kritikagithubtripathi/SOHO_Gigabit_Network_Switch/IMG/WhatsApp Image 2024-12-17 at 20.58.13_35f5fbce.jpg

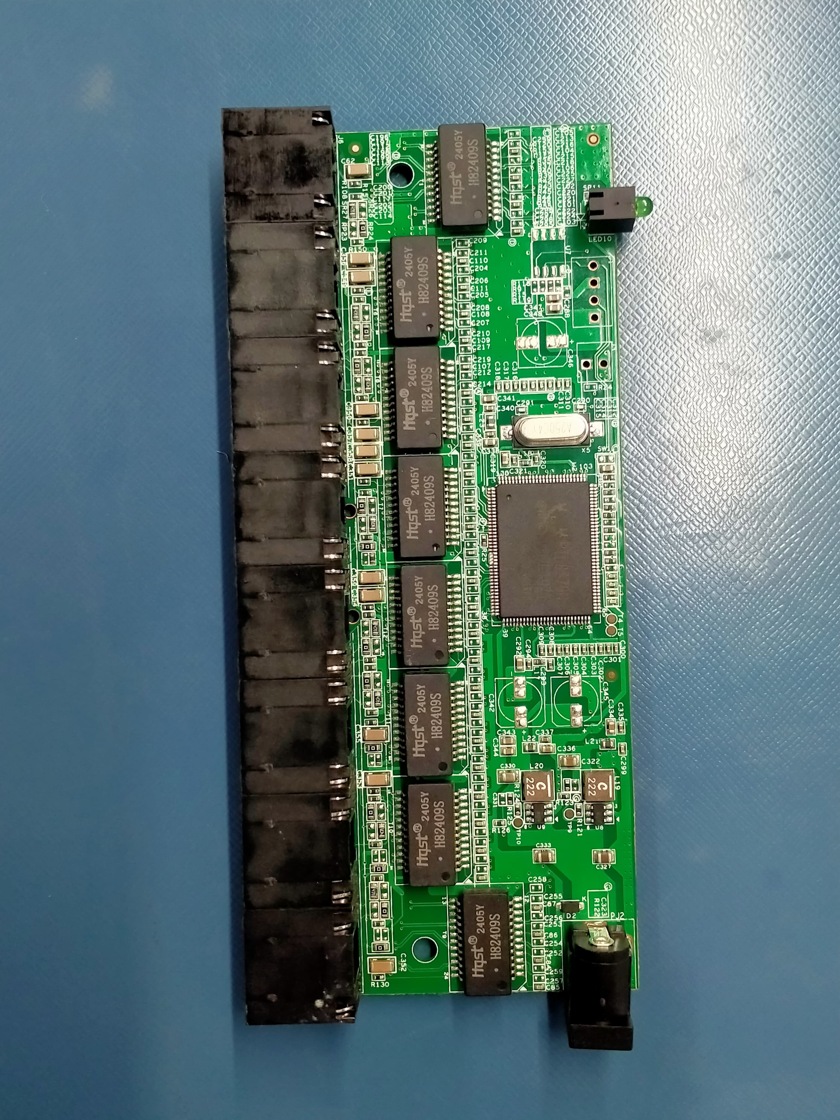
IMG/WhatsApp Image 2024-12-17 at 20.58.13_35f5fbce.jpg
