kritikagithubtripathi/SOHO_Gigabit_Network_Switch/IMG/WhatsApp Image 2024-12-17 at 20.58.07_0a7a4c7c.jpg

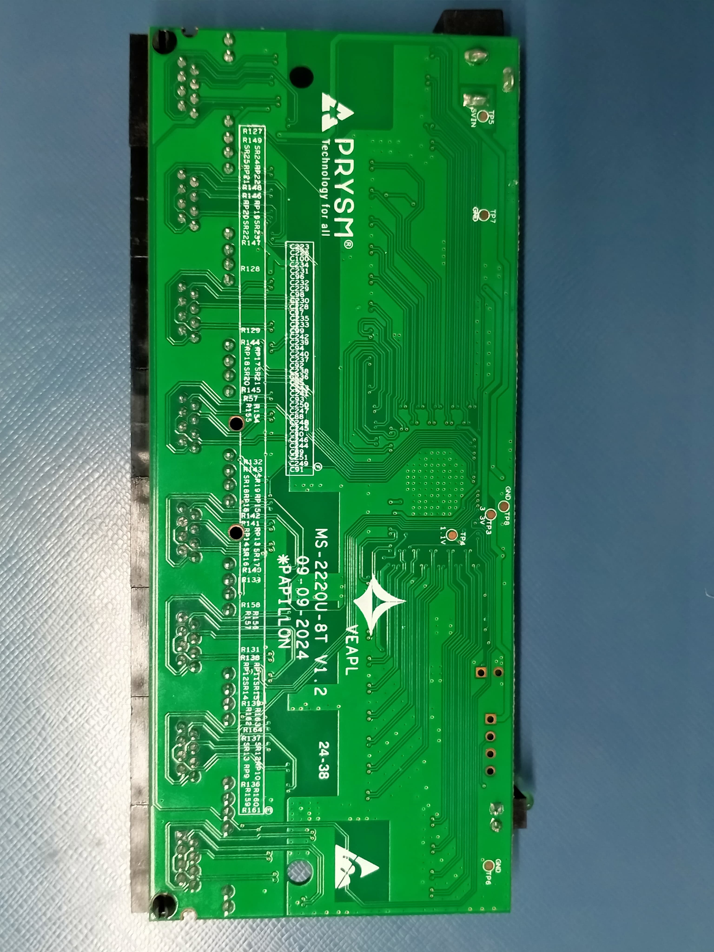
IMG/WhatsApp Image 2024-12-17 at 20.58.07_0a7a4c7c.jpg
