kritikagithubtripathi/SOHO_Gigabit_Network_Switch/IMG/WhatsApp Image 2024-12-17 at 20.58.14_88e8f59b.jpg

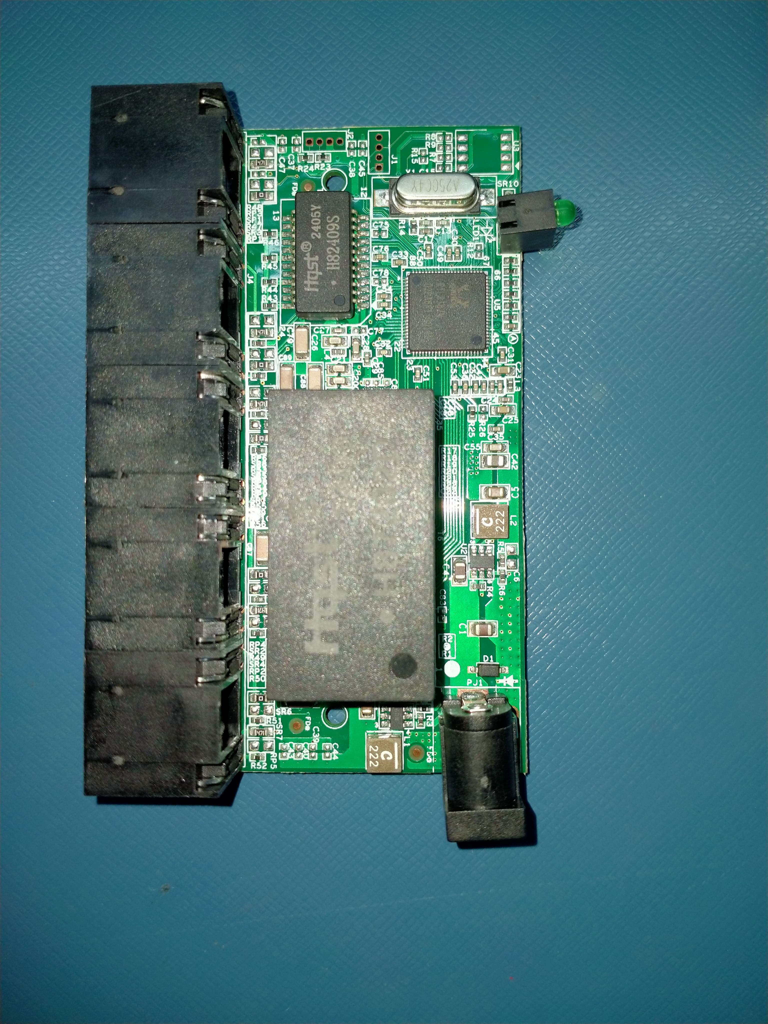
IMG/WhatsApp Image 2024-12-17 at 20.58.14_88e8f59b.jpg
