kritikagithubtripathi/SOHO_Gigabit_Network_Switch/Bill_of_Material(BOM)/Kyi - Leo MS -2210U-5T BOM.xlsx

Sheet: Revision History
 | Product Assembly BOM |  | QF / EG / 01 |  | Rev No. 3
 |  |  | Issue 02
Product Name : | Kyi-Leo - MS-2210U-5T
Product Code: | VEPL-MS-2210U-5T
Revision history:
Release Date | Rev No. | Change Description | Prepared By | Checked By | Remarks
12.04.2019 | 1 | Initial Release | Zaid | Nishath
24.08.2024 | 2 | 1.Power Circuit has been Changed - U1, U2 2.DNI List Update - U3, U4, C15, C16, R9, R13, R16 | Kritika | Zaid |  | 2
27.08.2024 | 3 | 3. Changed VEPL PN from VEPL418391215 to VEPL41839121 due to digit missmatch 4.Changed VEPL PN from VEPL218372007 to VEPL21837200 due to digit missmatch 5.Changed VEPL PN from VEPL318448360 to VEPL31844836 due to digit missmatch 6.Changed VEPL PN from VEPL418421001 to VEPL41842100 due to digit missmatch 7.Changed VEPL PN from VEPL418411000 to VEPL41841100 due to digit missmatch | Anitha | Ranjitha
2024-09-09 | 4 | 1.Added mechanical parts 2.Changed VEPL PN from VEPL118612010 to VEPL11861201 due to digit missmatch 3.Changed VEPL PN from VEPL118622002 to VEPL11862200 due to digit missmatch 4.Changed VEPL PN from VEPL118632210 to VEPL11863221 due to digit missmatch 5.Changed VEPL PN from VEPL118642215 to VEPL11864221 due to digit missmatch 6.Changed VEPL PN from VEPL718381545 to VEPL71838154 due to digit missmatch | Anitha | Ranjitha
09.10.2024 | 5 | Change RTL8367N-VB to RTL8367N-VB-CG | Kritika | Mayank

Sheet: BOM
 |  |  | Product Assembly BOM |  |  |  |  |  |  | QF / EG / 01 |  |  | Rev No. 3
 |  |  |  |  |  |  |  |  |  | Issue 02
Product Name : |  |  | Kyi-Leo - MS-2210U-5T |  |  |  |  |  | BOM Rev No: | 4 | Product Rev No: |  |  | 1.1
Product Code: |  |  | VEPL-MS-2210U-5T |  |  |  | BOM Type : |  | Issue Date: | 2024-09-09
Total No. of Line Items: |  |  | 28 |  |  |  | Total SMT locations: | 91 | Total PTH locations: | 4
Sl no. | Level | VEPL Part No | Prioprity Level | Value | PCB Footprint | Type | Description | Mfr | Mfr. Part No | Customer Part No | Qty/ Product | UOM | Reference | Assy Stage | MSL | ECN | Select BOM Type | MSL | Assy Stage
1 | 4 | VEPL25430407 | 1 | 4.7uF | C0805 | CAP | 4.7 uF, Ceramic Capacitor, 10V, X7R, size 0805 | Murata Samsung Electro-Mechanics TDK Corporation KEMET YAGEO | GRM21BR71A475KA73L CL21B475KPFNNNE C2012X7R1A475K125AC C0805C475K8RAC7800 CC0805KKX7R6BB475 |  | 2 | EA | C1,C4 | SMD |  |  | Design Validation | L1 | SMT
2 | 4 | VEPL24251000 | 1 | 10uF | C0805 | CAP | 10 uF, Ceramic Capacitor, 10V, X7R, size 0805 | Murata Samsung Electro-Mechanics YAGEO TDK Corporation KEMET | GRM21BR71A106KE51L CL21B106KPQNFNE CC0805KKX7R6BB106 C2012X7R1A106K125AC C0805C106K8RAC7800 |  | 2 | EA | C2,C5 | SMD |  |  | Engineering Validation | L2 | PTH
3 | 4 | VEPL21239030 | 1 | 30pF | C0402 | CAP | CAP CER 30PF 25V C0G/NP0 0402 | Murata Johanson Technology Inc. KEMET Venkel Vishay Vitramon | GRM1555C1E300JA01D QSCF250Q300J1GV001T C0402C300J3GAC7867 C0402C0G250-300JNE VJ0402D300JXXAC |  | 2 | EA | C13,C14 | SMD |  |  | Mfg Pilot | L3 | FA/BB
4 | 4 | VEPL21834160 | 1 | 0.1uF | C0402 | CAP | CAP CER 0.1UF 16V X5R 0402 | Murata KYOCERA AVX KEMET YAGEO Walsin Technology Corporation | GRM155R61C104KA88D KGM05AR51C104KH C0402C104K4PAC7867 CC0402KRX5R7BB104 0402X104K160CT |  | 6 | EA | C17,C18,C22,C24,C27,C29 | SMD |  |  | Mass Production |  | Consumables
5 | 4 | VEPL23640160 | 1 | 1UF/16V | C0603 | CAP | CAP CER 1UF 16V X5R 0603 | KEMET KYOCERA AVX Murata Electronics TDK TAIYO YUDEN | C0603C105K4PACTU KGM15BR51C105KT GRM185R61C105KE44J CGA3E1X5R1C105K080AC EMK107BJ105KAHT |  | 8 | EA | C19,C20,C21,C23,C25,C26,C28,C55 | SMD |  |  |  |  | Mechanical
6 | 4 | VEPL21836161 | 1 | 0.01uF | C0402 | CAP | CAP CER 0.01UF 16V X7R 0402 | Walsin Technology Murata Electronics YAGEO KEMET Samsung Electro-Mechanics | 0402B103K160CT GRM155R71C103KA01D CC0402KRX7R7BB103 C0402C103K4RAC7867 CL05B103KO5NNNC |  | 16 | EA | C30,C31,C32,C33,C34,C35,C36,C41, C48,C49,C50,C51,C52,C53,C54,C76 | SMD |  |  |  |  | Label
7 | 4 | VEPL21833161 | 1 | 10UF/16V | C0805 | CAP | CAP CER 10UF 16V X5R 0805 | Samsung Murata Electronics KEMET TDK Corporation YAGEO | CL21A106KOCLRNC GRM21BR61C106KE15K C0805C106K4PAC7800 C2012X5R1C106K085AC CC0805KKX5R7BB106 |  | 1 | EA | C42 | SMD
8 | 4 | VEPL21837200 | 1 | 1nF/2kv | C1206 | CAP | CAP CER 1000PF 2KV X7R 1206 | KEMET Vishay / Vitramon KYOCERA AVX YAGEO | C1206C102KGRACTU VJ1206Y102KXFAT4X 1206GC102KAZ1A CC1206KKX7RDBB102 |  | 5 | EA | C79,C82,C87,C88,C89 | SMD
9 | 4 | VEPL36063005 | 1 | AZ3005-01G | SOD123 | Diode | TVS SURGE PROTECTOR 1-CH 5V | AMAZING | AZ3005-01G |  | 1 | EA | D1 | SMD
10 | 4 | VEPL71838154 | 1 | rj451x5 | rj45_5port | CONN | CONN 1X5 With Two LED - RJ45, Plastic | UTE | 31124.50101.011300 |  | 1 | EA | J4 | PTH
11 | 4 | VEPL41240364 | 1 | LED(RED) | LED | LED | Right angle Green LED TH | Kohon Opto Electronics | KHL3642GD43-DZ |  | 1 | EA | LED1 | PTH
12 | 4 | VEPL35431202 | 1 | 2.2uH | XAL4020-222ME | IND | FIXED IND 2.2UH 5.5A 38.7MOHM SM | Colicraft | XAL4020-222MEC |  | 2 | EA | L1,L2 | SMD
13 | 4 | VEPL41839121 | 1 | SBY100505T-121Y-(500mA) | L0402 | BEAD | Ferrite Bead 120Ohm @100Mhz 500mA | CHILISIN ELECTRONICS CORP | SBY100505T-121Y |  | 2 | EA | L3,L4 | SMD
14 | 4 | VEPL71309039 | 1 | DC JACK | DC_JB11_03 | CONN | CONN PWR JACK 2 X 5.5 MM | JCTC | JAB11-03BH911XAL-X 2.0mm |  | 1 | EA | PJ1 | PTH
15 | 4 | VEPL11490000 | 1 | 0R | R0603 | RES | RES SMD 0 OHM JUMPER 1/10W 0603 | Panasonic YAGEO Stackpole Electronics Vishay Dale | ERJ-3GEY0R00V AF0603FR-070RL RMCF0603ZT0R00 CRCW06030000Z0EA |  | 5 | EA | RP1,RP4,RP7,RP8,RP10 | SMD
16 | 4 | VEPL11100453 | 1 | 453K | R0402 | RES | RES 453K OHM 1% 1/16W 0402 | YAGEO Bourns Inc. Vishay Dale Stackpole Electronics Inc | RC0402FR-07453KL CR0402-FX-4533GLF CRCW0402453KFKED RMCF0402FT453K |  | 1 | EA | R1 | SMD
17 | 4 | VEPL12900100 | 1 | 100K | R0402 | RES | RES 100K OHM 1% 1/10W 0402 | Panasonic KOA Speer Electronics, Inc. Würth Elektronik Kamaya | ERJ-2RKF1003X RK73H1ETTP1003F 560112110019 RMC1/16SK1003FTH |  | 2 | EA | R2,R6 | SMD
18 | 4 | VEPL11290499 | 1 | 499K | R0402 | RES | RES 499K OHM 1% 1/10W 0402 | Panasonic KOA Speer Electronics, Inc. Kamaya | ERJ-2RKF4993X RK73H1ETTP4993F RMC1/16SK4993FTH |  | 2 | EA | R3,R4 | SMD
19 | 4 | VEPL14523825 | 1 | 82.5K | R0402 | RES | RES 82.5K OHM 1% 1/16W 0402 | YAGEO Bourns Inc. Stackpole Electronics Inc Vishay Dale KOA Speer Electronics, Inc | RT0402FRE0782K5L CR0402-FX-8252GLF RMCF0402FT82K5 CRCW040282K5FKED RN73H1ETTP8252F25 |  | 1 | EA | R5 | SMD
20 | 4 | VEPL11126407 | 1 | 4.7K | R0402 | RES | RES SMD 4.7K OHM 5% 1/10W 0402 | Panasonic KOA Speer Electronics, Inc. Kamaya Inc. Walsin Technology Corporation | ERJ-2GEJ472X RK73B1ETTP472J RMC1/16S-472JTH MR04X472 JTL |  | 17 | EA | R14,R17,R18,R19,R20,R21,R22,R23,R24,R49,R50,R51,R52,R53,R54,R55,R56 | SMD
21 | 4 | VEPL11840249 | 1 | 2.49K | R0402 | RES | RES SMD 2.49K OHM 1% 1/10W 0402 | Panasonic KOA Speer Electronics, Inc. Würth Elektronik Kamaya Inc. | ERJ-2RKF2491X RK73H1ETTP2491F 560112110224 RMC1/16SK2491FTH |  | 1 | EA | R25 | SMD
22 | 4 | VEPL11243075 | 1 | 75R | R0402 | RES | RES SMD 75 OHM 5% 1/10W 0402 | Panasonic KOA Speer Electronics, Inc. Kamaya Inc. Würth Elektronik | ERJ-2GEJ750X RK73B1ETTP750J RMC1/16S-750JTH 560112110028 |  | 4 | EA | R43,R44,R45,R46 | SMD
23 | 4 | VEPL11330470 | 1 | 470R | R0603 | RES | RES SMD 470 OHM 5% 1/10W 0603 | Yageo Vishay Dale Panasonic TE Connectivity Stackpole Electronics Inc | RC0603JR-07470RL CRCW0603470RJNEBC ERJ-3GEYJ471V CRGCQ0603J470R RMCF0603JT470R |  | 6 | EA | SR1,SR4,SR7,SR8,SR10,SR11 | SMD
24 | 4 | VEPL41841100 | 1 | HS2401S | sop24 | Module | 10/100/1000 BASE-T Single PORT SMD MODULE | HQST | HS2401S H82409S |  | 1 | EA | T5 | SMD
25 | 4 | VEPL41842100 | 1 | LP5027NL | DIP72 | Module | 10/100/1000 BASE-T QUAD PORT TH MODULE | LINK PP | LP5027NL |  | 1 | EA | T6 | PTH
26 | 4 | VEPL35432236 | 1 | TLV62569PDDC | SOT23-6 | Converter | IC REG BUCK ADJ 2A SOT23-6 | TI | TLV62569PDDC |  | 2 | EA | U1,U2 | SMD
27 | 4 | VEPL31844836 | 1 | RTL8367N-VB-CG | QFN88 | IC | 5 Port 10/100/1000M IC_ | Realtek | RTL8367N-VB-CG |  | 1 | EA | U5 | SMD
28 | 4 | VEPL94510252 | 1 | 25MHZ | CRY_2P_HC_49SMD | Crsytal | CRYSTAL 25.0000MHZ 18PF SMD | Abracon LLC | ABLS-25.000MHZ-B2F-T |  | 1 | EA | X1 | SMD
29 | 4 | VEPL918458012 |  | NA |  | PCB | Bare PCB - MS-2210U - PCB Dimension : 80.5 (L) * 46.8 (W) * 1.2 (T) ,FR4 Material , 2 Layer ,OSP Finish ,1oz Copper thickness . | i)Epitome Components Ltd ii) Guangdong Champion Asia Electronics Co Ltd. iii) Ascent Circuits Pvt Ltd iv) Shenzhen Posin Circuit Technology Co Ltd v) Ucreate PCB Co Ltd vi) Global Success Circuits Co LTD vii) Shye Feng Enterprise (Thailand) co LTD Viii) Gerg Electronics (INDIA Circuit ) iX) HECPCB TECHNOLOGY CO., LTD | NA |  | NA | NA | NA | NA
30 | 1 | VEPL91459020 |  |  |  |  | Power Adapter - 5V , 1Amp - DC PIN - 5.5 x 2.1mm | Velankani Electronics PvT LTD Velankani Electronics PvT LTD | PA011205020 PRYSM5V1P2A |  | 1 | EU
31 | 2 | VEPL11861201 |  |  |  |  | SoHo TOP Cover - Plastic | Velankani Electronics PvT LTD - Unit-II | NW-2001-P-0001 |  | 1 | EU
32 | 2 | VEPL11862200 |  |  |  |  | SoHo Bottom Cover - Plastic | Velankani Electronics PvT LTD - Unit-II | NW-2001-P-0002 |  | 1 | EU
33 | 2 | VEPL11863221 |  |  |  |  | Gift BOX - 170 x 110 x 54mm | Velankani Electronics PvT LTD - Unit-II | PKG- MS-2210U-5T |  | 1 | EU
34 | 2 | VEPL11864221 |  |  |  |  | MS-2210U-5T - UNIT Lable | Velankani Electronics PvT LTD - Unit-II | LABLE- MS-2210U-5T |  | 2 | EU
Approved By: |  |  |  |  |  |  |  | Note :
Name: |  | Ranjitha |  |  |  |  |  | EA ------> Each Assembly ; EU ------> Each Unit ; SMT -----> Surface Mount Device Assy ; T.H ------> Through Hole Assy
Date: |  | 2024-09-09

Sheet: DNP
 | Product Assembly BOM |  |  | QF / EG / 01 |  | Rev No. 3
 |  |  |  | Issue 02
Product Name : | Kyi-Leo - MS-2210U-5T |  |  | BOM Rev No: | 4 | Product Rev No: | 1.1
Product Code: | VEPL-MS-2210U-5T |  |  | Issue Date: | 2024-09-09
DONOT POPULATE LIST
Sl No. | Qty / Product | Reference | PCB Footprint | Remarks
1 | 2 | C3,C6 | C0603 | 6.8pF/NC
1 | 2 | C15,C16 | C0402 | 0.1uF/NC
2 | 15 | C37,C38,C39,C40,C43,C44,C45,C47,C75,C77,C78,C83,C84,C85,C86 | C0402 | 0.01uF/NC
3 | 1 | C46 | C0805 | 10UF/16V/NC
4 | 1 | C56 | C0603 | 1UF/16V/NC
5 | 2 | J1,J2 | sip_4p_1-27p | NC-1X4PIN
6 | 1 | RA1 | 8P4r22 | NC-33/5%
7 | 5 | RP2,RP3,RP5,RP6,RP9 | R0603 | 0R/NC
8 | 12 | R7,R8,R9,R10,R11,R12,R13,R15,R16,R26,R47,R48 | R0402 | NC/4.7K
9 | 5 | SR2,SR3,SR5,SR6,SR9 | R0603 | 470R/NC
10 | 1 | SW1 | R0603 | NC
11 | 1 | U3 | SO8 | AT24C01D-SSHM-B / NC
12 | 8 | TP1,TP2,TP3,TP4,TP5,TP6,TP7,TP8 | T POINT A
13 | 1 | U4 | sop8_300 | W25Q80_0
Approved By:
Name: | Ranjitha
Date: | 2024-09-09
