kritikagithubtripathi/SOHO_Gigabit_Network_Switch/Bill_of_Material(BOM)/PAPILLION MS-2220U-8T BOM.xlsx

Sheet: Revision History
 | Product Assembly BOM |  | QF / EG / 01 |  | Rev No. 3
 |  |  | Issue 02
Product Name : | Papillon - MS-2220U-8T
Product Code: | VEPL-MS-222U-8T
Revision history:
Release Date | Rev No. | Change Description | Prepared By | Checked By | Remarks
12.04.2019 | 1 | Initial Draft | Zaid | Nishath
09.07.2019 | 2 | Initial Release | Zaid | Jayanth
28.08.2024 | 3 | 1.Power Circuit has been Changed - U8, U9 2.DNI List Update -C288, R9 | Kritika | Zaid
2024-08-29 | 4 | Changed VEPL718482845 to VEPL71848284 due to digit miss match Changed VEPL318518370 to VEPL31851837 due to digit miss match | Manjunath | Ranjitha
2024-09-10 | 5 | 1.Changed VEPL118652003 to VEPL11865200 due to digit missmatch 2.Changed VEPL118662004 to VEPL11866200 due to digit missmatch 3.Changed VEPL118672208 to VEPL11867220 due to digit missmatch 4.Changed VEPL118682228 to VEPL11868222 due to digit missmatch | Anitha | Ranjitha
09.10.2024 | 6 | Change RTL8370N-VB to RTL8370N-VB-CG | Kritika | Mayank

Sheet: BOM
 |  |  | Product Assembly BOM |  |  |  |  |  |  | QF / EG / 01 |  |  | Rev No. 3
 |  |  |  |  |  |  |  |  |  | Issue 02
Product Name : |  |  | Papillon - MS-2220U-8T |  |  |  |  |  | BOM Rev No: | 5.0 | Product Rev No: |  |  | 1.2
Product Code: |  |  | VEPL-MS-222U-8T |  |  |  | BOM Type : | Design Validation | Issue Date: | 2024-09-10
Total No. of Line Items: |  |  | 27 |  |  |  | Total SMT locations: | 175 | Total PTH locations: | 3
Sl no. | Level | VEPL Part No | Prioprity Level | Value | PCB Footprint | Type | Description | Mfr | Mfr. Part No | Customer Part No | Qty/ Product | UOM | Reference | Assy Stage | MSL | ECN | Select BOM Type | MSL | Assy Stage
1 | 4 | VEPL21837200 | 1 | 1nF/2kv | C1206 | CAP | CAP CER 1000PF 2KV X7R 1206 | KEMET YAGEO Johanson Dielectrics Inc. Vishay/Vitramon | C1206C102KGRACTU CC1206KKX7RDBB102 VPDD202W102K1GV001E 77-VJ1206Y102KXFAT4X |  | 12 | EA | C62,C349,C350,C351,C352,C353,C354,C355,C356,C357,C358,C359 | SMT |  |  | Design Validation | L1 | SMT
2 | 4 | VEPL21836161 | 1 | 0.01uF / 16V | C0402 | CAP | CAP CER 0.01UF 16V X7R 0402 | Walsin Technology Murata Electronics KEMET YAGEO Samsung Electro-Mechanics | 0402B103K160CT GRM155R71C103KA01J C0402T103K4RACTU CC0402KRX7R7BB103 CL05B103KO5NNNC |  | 56 | EA | C84,C85,C86,C87,C88,C89,C90,C91,C92,C93,C94,C95,C96,C97,C98,C99, C100,C101,C102,C103,C104,C105,C106,C107,C108,C109,C110,C111,C112,C113,C114,C117 C295,C296,C297,C298,C299,C300,C301,C302,C303,C304,C305, C306,C307,C308,C309,C310,C311,C312,C313,C314,C315,C316,C317,C318 | SMT |  |  | Engineering Validation | L2 | PTH
3 | 4 | VEPL23640160 | 1 | 1uF/16V | C0603 | CAP | CAP CER 1UF 16V X5R 0402 | KEMET Murata Electronics KYOCERA AVX TDK TAIYO YUDEN | C0603C105K4PACTU GRT188R61C105KE13D 0603YD105KAT2A C1608X5R1C105K080AA EMK107BJ105KK-T |  | 11 | EA | C289,C292,C319,C334,C336,C338,C341,C343,C344,C347,C348 | SMT |  |  | Mfg Pilot | L3 | FA/BB
4 | 4 | VEPL21239030 | 1 | 30pF | C0402 | CAP | CAP CER 30PF 25V C0G/NP0 0402 | Murata KEMET Venkel Johanson Technology Inc. Vishay Vitramon | GRM1555C1E300JA01D C0402C300J3GAC7867 C0402C0G250-300JNE QSCF250Q300J1GV001T VJ0402D300JXXAC |  | 2 | EA | C290,C291 | SMT |  |  | Mass Production |  | Consumables
5 | 4 | VEPL21834160 | 1 | 0.1uF | C0402 | CAP | CAP CER 0.1UF 16V X5R 0402 | Murata KYOCERA AVX KEMET Samsung Electro-Mechanics TDK Corporation | GRM155R61C104KA88D KGM05AR51C104KH C0402C104K4PAC7867 CL05A104KO5NNNC C1005X5R1C104K050BA |  | 8 | EA | C293,C294,C320,C321,C335,C337,C339,C340 | SMT |  |  |  |  | Mechanical
7 | 4 | VEPL24251000 | 1 | 10uF | C0805 | CAP | 10 uF, Ceramic Capacitor, 10V, X7R, size 0805 | Murata Samsung Electro-Mechanics YAGEO TDK Corporation KEMET | GRM21BR71A106KE51L CL21B106KPQNFNE CC0805KKX7R6BB106 C2012X7R1A106K125AC C0805C106K8RAC7800 |  | 2 | EA | C322,C330 | SMT |  |  |  |  | Label
8 | 4 | VEPL25430407 | 1 | 4.7uF | C0805 | CAP | 4.7 uF, Ceramic Capacitor, 10V, X7R, size 0805 | Murata Samsung Electro-Mechanics TDK Corporation KEMET YAGEO | GRM21BR71A475KA73L CL21B475KPFNNNE C2012X7R1A475K125AC C0805C475K8RAC7800 CC0805KKX7R6BB475 |  | 2 | EA | C327,C333 | SMT
9 | 4 | VEPL36063005 | 1 | AZ3005-01G | SOD123 | Diode | TVS SURGE PROTECTOR 1-CH 5V | AMAZING | AZ3005-01G |  | 1 | EA | D2 | SMT
10 | 4 | VEPL71848284 | 1 | 1X8_2LED | 1X8_2LED | Conn | 1X8 Plastic With 2LED RJ45 Connector | UTE | 31124.80101.011300 |  | 1 | EA | J6 | PTH
11 | 4 | VEPL41240364 | 1 | LED(RED) | LED-1PORT-2p54MM | LED | Right angle Green LED TH | Kohon Opto Electronics | KHL3642GD43-DZ |  | 1 | EA | LED10 | PTH
12 | 4 | VEPL41839121 | 1 | SBY100505T-121Y-(500mA) | L0402 | Bead | Ferrite Bead 120Ohm @100Mhz 500mA | CHILISIN ELECTRONICS CORP | SBY100505T-121Y |  | 2 | EA | L17,L18 | SMT
13 | 4 | VEPL35431202 | 1 | 2.2uH | XAL4020-222ME | IND | 2.2uH, Power Inductor | Colicraft | XAL4020-222ME |  | 2 | EA | L19,L20 | SMT
14 | 4 | VEPL41849102 | 1 | 120ohm@100Mhz,2A | L0603 | Bead | Ferrite Bead 120Ohm @100Mhz 2AMax | Vishay Dale | ILHB0603ER121V |  | 3 | EA | L21,L22,L23 | SMT
15 | 4 | VEPL71309039 | 1 | DC JACK | DC_JB11_03 | Conn | CONN PWR JACK 2 X 5.5 MM | JCTC | JAB11-03BH911XAL-X 2.0mm |  | 1 | EA | PJ2 | PTH
16 | 4 | VEPL11490000 | 1 | 0R | R0603 | RES | RES SMD 0 OHM JUMPER 1/10W 0603 | Panasonic Stackpole Electronics YAGEO Vishay Dale | ERJ-3GEY0R00V RMCF0603ZT0R00 RC0603JR-070RL CRCW06030000Z0EA |  | 12 | EA | RP10,RP12,RP14,RP16,RP18,RP20,RP22,RP24,R57,R158,R161,R164 | SMT
17 | 4 | VEPL11126407 | 1 | 4.7K | R0402 | RES | RES SMD 4.7K OHM 5% 1/10W 0402 | Panasonic KOA Speer Electronics, Inc. Kamaya Inc. Walsin Technology Corporation | ERJ-2GEJ472X RK73B1ETTP472J RMC1/16S-472JTH MR04X472 JTL |  | 26 | EA | R9,R120,R136,R137,R138,R139,R140,R141,R142, R143,R144,R145,R146,R147,R148,R149,R150,R151 R37,R40,R42,R44,R46,R152,R154,R156 | SMT
18 | 4 | VEPL11840249 | 1 | 2.49K / 1% | R0402 | RES | RES SMD 2.49K OHM 1% 1/16W 0402 | Walsin Technology Corp. Vishay Dale YAGEO Stackpole Electronics Inc Rohm Semiconductor | WR04X2491FTL CRCW04022K49FKED RC0402FR-072K49L RMEF0402FT2K49 SFR01MZPF2491 |  | 1 | EA | R25 | SMT
21 | 4 | VEPL11243075 | 1 | 75 / 5% | R0402 | RES | RES SMD 75 OHM 5% 1/10W 0402 | Panasonic KOA Speer Electronics, Inc. Kamaya Inc. Würth Elektronik | ERJ-2GEJ750X RK73B1ETTP750J RMC1/16S-750JTH 560112110028 |  | 8 | EA | R108,R127,R128,R129,R130,R131,R132,R133 | SMT
22 | 4 | VEPL11290499 | 1 | 499K | R0402 | RES | RES 499K OHM 1% 1/10W 0402 | Panasonic KOA Speer Electronics, Inc. Kamaya | ERJ-2RKF4993X RK73H1ETTP4993F RMC1/16SK4993FTH |  | 2 | EA | R121,R124 | SMT
23 | 4 | VEPL11100453 | 1 | 453K | R0402 | RES | RES 453K OHM 1% 1/16W 0402 | YAGEO Bourns Inc. Vishay Dale Stackpole Electronics Inc | RC0402FR-07453KL CR0402-FX-4533GLF CRCW0402453KFKED RMCF0402FT453K |  | 1 | EA | R122 | SMT
24 | 4 | VEPL12900100 | 1 | 100K | R0402 | RES | RES 100K OHM 1% 1/10W 0402 | Panasonic KOA Speer Electronics, Inc. Würth Elektronik Kamaya | ERJ-2RKF1003X RK73H1ETTP1003F 560112110019 RMC1/16SK1003FTH |  | 2 | EA | R123,R126 | SMT
25 | 4 | VEPL14523825 | 1 | 82.5K | R0402 | RES | RES 82.5K OHM 1% 1/16W 0402 | YAGEO Bourns Inc. Stackpole Electronics Inc Vishay Dale KOA Speer Electronics, Inc | RT0402FRE0782K5L CR0402-FX-8252GLF RMCF0402FT82K5 CRCW040282K5FKED RN73H1ETTP8252F25 |  | 1 | EA | R125 | SMT
26 | 4 | VEPL11330470 | 1 | 470R | R0603 | RES | RES SMD 470 OHM 5% 1/10W 0603 | Yageo Panasonic Electronic TE Connectivity Passive Product Stackpole Electronics Inc Vishay Dale Bourns Inc. | RC0603JR-07470RL ERJ-3GEYJ471V CRGCQ0603J470R RMCF0603JT470R CRCW0603470RJNEBC CR0603-JW-471ELF |  | 9 | EA | SR11,SR13,SR15,SR17,SR19,SR21,SR23,SR25,SR27 | SMT
27 | 4 | VEPL41841100 | 1 | H82409S | SOP24 | Module | 10/100/1000 BASE-T Single PORT SMD MODULE | HQST HauSheng Semiconductor Tech | H82409S HS2401S |  | 8 | EA | T1,T6,T7,T8,T9,T10,T11,T12 | SMT
28 | 4 | VEPL31851837 | 1 | RTL8370N-VB-CG | LQFP128 | IC | REALTEK, 10/100/1000 8 PORT IC | Realtek Semiconductor Corp. | RTL8370N-VB-CG |  | 1 | EA | U2 | SMT
30 | 4 | VEPL35432236 | 1 | TLV62569PDDC | SOT23-6 | Converter | IC REG BUCK ADJ 2A SOT23-6 | TI | TLV62569PDDC |  | 2 | EA | U8,U9 | SMT
31 | 4 | VEPL94510252 | 1 | 25MHZ | CRY_2P_HC-49SMD | Crystal | CRYSTAL 25.0000MHZ 18PF SMD | Abracon LLC | ABLS-25.000MHZ-B2F-T |  | 1 | EA | X5 | SMT
32 | 4 | VEPL918461275 |  |  |  | PCB | Bare PCB - MS2220U-8T - ,PCB Dimension : 127.8 (L) * 53 (W) * 1.2 (T) ,FR4 Material , 2 Layer ,OSP Finish ,1oz Copper thickness . | i)Epitome Components Ltd ii) Guangdong Champion Asia Electronics Co Ltd. iii) Ascent Circuits Pvt Ltd iv) Shenzhen Posin Circuit Technology Co Ltd v) Ucreate PCB Co Ltd vi) Global Success Circuits Co LTD vii) Shye Feng Enterprise (Thailand) co LTD Viii) Gerg Electronics (INDIA Circuit ) iX) HECPCB TECHNOLOGY CO., LTD
33 |  | VEPL91459020 |  |  |  |  | Power Adapter - 5V , 1Amp - DC PIN - 5.5 x 2.1mm | Velankani Electronics PvT LTD Velankani Electronics PvT LTD | PA011205020 PRYSM5V1P2A
34 |  | VEPL11865200 |  |  |  |  | SoHo TOP Cover - Plastic | Velankani Electronics PvT LTD - Unit-II | NW-2001-P-0003
35 |  | VEPL11866200 |  |  |  |  | SoHo Bottom Cover - Plastic | Velankani Electronics PvT LTD - Unit-II | NW-2001-P-0004
36 |  | VEPL11867220 |  |  |  |  | Gift BOX - 170 x 110 x 54mm | Velankani Electronics PvT LTD - Unit-II | PKG- MS-2220U-8T
37 |  | VEPL11868222 |  |  |  |  | MS-2220U-8T - UNIT Lable | Velankani Electronics PvT LTD - Unit-II | LABLE- MS-2220U-8T
Approved By: |  |  |  |  |  |  |  | Note :
Name: |  | Ranjitha |  |  |  |  |  | EA ------> Each Assembly ; EU ------> Each Unit ; SMT -----> Surface Mount Device Assy ; T.H ------> Through Hole Assy
Date: |  | 2024-09-10

Sheet: DNP
 | Product Assembly BOM |  |  | QF / EG / 01 |  | Rev No. 3
 |  |  |  | Issue 02
Product Name : | Papillon - MS-2220U-8T |  |  | BOM Rev No: | 5 | Product Rev No: | 1.2
Product Code: | VEPL-MS-222U-8T |  |  | Issue Date: | 2024-09-10
DONOT POPULATE LIST
Sl No. | Qty / Product | Reference | PCB Footprint | Remarks
1 | 1 | J1 | SIP_4P_2p54 | CONN HEADER VERT 4POS .100 TIN
2 | 1 | J3 | SIP_2P_2p54 | CONN HEADER VERT 2POS .100 TIN
3 | 8 | RP9,RP11,RP13,RP15,RP17,RP19,RP21,RP23 | R0603 | RES SMD 0 OHM JUMPER 1/10W 0603
4 | 3 | R15,R118,R119 | R0402 | RES SMD 4.7K OHM 5% 1/10W 0402
5 | 1 | R24 | R0402 | NC_33 / 5%
6 | 12 | R35,R39,R43,R45,R55,R153,R155,R157,R159,R160,R162,R163 | R0402 | RES SMD 4.7K OHM 5% 1/10W 0402
7 | 8 | SR12,SR14,SR16,SR18,SR20,SR22,SR24,SR26 | R0603 | 470R /NC
8 | 1 | SW1 | R0603 | NC
9 | 1 | U7 | SO8 | AT24C01D-SSHM-B / NC
10 | 1 | C288 | C0402 | CAP CER 0.1UF 16V X5R 0402
11 | 3 | C342,C345,C346 | CAP_AE_CAN_D | CAPXON_100uF/16V Chip Type
12 | 2 | C323,C331 | C0603 | 6.8pF/NC
13 | 64 | C196,C197,C198,C199,C200,C201,C202,C203,C204,C205,C206,C207,C208, C209,C210,C211,C212,C213,C214,C215,C216,C217,C218,C219,C220,C221, C222,C223,C224,C225,C226,C227,C228,C229,C230,C231,C232,C233,C234, C235,C236,C237,C238,C239,C240,C241,C242,C243,C244,C245,C246,C247, C248,C249,C250,C251,C252,C253,C254,C255,C256,C257,C258,C259 | C0402 | CAP SMD 15pf 50V 5% NPO 0402
14 | 10 | TP3,TP4,T4,TP5,T5,TP6,TP7,TP8,TP9,TP10 | TP1P2MM | T POINT A
Approved By:
Name: | Ranjitha
Date: | 2024-09-10
