kritikagithubtripathi/SOHO_Gigabit_Network_Switch/NETLIST/RTL8367N-VB-5GE-SCH_NETLIST.XLS

*PADS-PCB*
*PART*
C1 C0805
C13 C0402
C14 C0402
C15 C0402
C16 C0402
C17 C0402
C18 C0402
C19 C0603
C2 C0805
C20 C0603
C21 C0603
C22 C0402
C23 C0603
C24 C0402
C25 C0603
C26 C0603
C27 C0402
C28 C0603
C29 C0402
C3 c0603
C30 C0402
C31 C0402
C32 C0402
C33 C0402
C34 C0402
C35 C0402
C36 C0402
C37 C0402
C38 C0402
C39 C0402
C4 C0805
C40 C0402
C41 C0402
C42 C0805
C43 C0402
C44 C0402
C45 C0402
C46 C0805
C47 C0402
C48 C0402
C49 C0402
C5 C0805
C50 C0402
C51 C0402
C52 C0402
C53 C0402
C54 C0402
C55 C0603
C56 C0603
C6 c0603
C75 C0402
C76 C0402
C77 C0402
C78 C0402
C79 C1206
C82 C1206
C83 C0402
C84 C0402
C85 C0402
C86 C0402
C87 C1206
C88 C1206
C89 C1206
D1 SOD123
J1 SIP_4P_1-27P
J2 SIP_4P_1-27P
J4 rj45_5port
L1 SWPA4030S4R7MT
L2 SWPA4030S4R7MT
L3 L0402
L4 L0402
LED1 LED_CASE
PJ1 DC_JB11_03
R1 R0402
R10 R0402
R11 R0402
R12 R0402
R13 R0402
R14 R0402
R15 R0402
R16 R0402
R17 R0402
R18 R0402
R19 R0402
R2 R0402
R20 R0402
R21 R0402
R22 R0402
R23 R0402
R24 R0402
R25 R0402
R26 R0402
R3 R0402
R4 R0402
R43 R0402
R44 R0402
R45 R0402
R46 R0402
R47 R0402
R48 R0402
R49 R0402
R5 R0402
R50 R0402
R51 R0402
R52 R0402
R53 R0402
R54 R0402
R55 R0402
R56 R0402
R6 R0402
R7 R0402
R8 R0402
R9 R0402
RA1 8P4r22
RP1 R0603
RP10 R0603
RP2 R0603
RP3 R0603
RP4 R0603
RP5 R0603
RP6 R0603
RP7 R0603
RP8 R0603
RP9 R0603
SR1 R0603
SR10 R0603
SR11 R0603
SR2 R0603
SR3 R0603
SR4 R0603
SR5 R0603
SR6 R0603
SR7 R0603
SR8 R0603
SR9 R0603
SW1 R0603
T5 sop24
T6 DIP72
TP1 TP1P2MM
TP2 TP1P2MM
TP3 TP1P2MM
TP4 TP1P2MM
TP5 TP1P2MM
TP6 TP1P2MM
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
*SIGNAL* P2MDIBP
U5.18 T6.24
*SIGNAL* P2MDIC+
T6.51 J4.20
*SIGNAL* P2MDIC-
T6.52 J4.21
*SIGNAL* P2MDICN
U5.22 T6.21
*SIGNAL* P2MDICP
U5.21 T6.22
*SIGNAL* P2MDID+
T6.53 J4.23
*SIGNAL* P2MDID-
T6.54 J4.24
*SIGNAL* P2MDIDN
U5.24 T6.19
*SIGNAL* P2MDIDP
U5.23 T6.20
*SIGNAL* P3LED0
U5.68 SR2.1 RP4.2
*SIGNAL* P3LED1
U5.67 SR4.1 RP2.2
*SIGNAL* P3MDIA+
T6.56 J4.25
*SIGNAL* P3MDIA-
T6.57 J4.26
*SIGNAL* P3MDIAN
U5.27 T6.16
*SIGNAL* P3MDIAP
U5.26 T6.17
*SIGNAL* P3MDIB+
T6.58 J4.27
*SIGNAL* P3MDIB-
T6.59 J4.30
*SIGNAL* P3MDIBN
U5.29 T6.14
*SIGNAL* P3MDIBP
U5.28 T6.15
*SIGNAL* P3MDIC+
T6.60 J4.28
*SIGNAL* P3MDIC-
T6.61 J4.29
*SIGNAL* P3MDICN
U5.32 T6.12
*SIGNAL* P3MDICP
U5.31 T6.13
*SIGNAL* P3MDID+
T6.62 J4.31
*SIGNAL* P3MDID-
T6.63 J4.32
*SIGNAL* P3MDIDN
U5.34 T6.10
*SIGNAL* P3MDIDP
U5.33 T6.11
*SIGNAL* P4LED0
U5.65 SR6.1 RP7.2
*SIGNAL* P4LED1
U5.66 SR7.1 RP5.2
*SIGNAL* P4MDIA+
T6.65 J4.33
*SIGNAL* P4MDIA-
T6.66 J4.34
*SIGNAL* P4MDIAN
U5.44 T6.7
*SIGNAL* P4MDIAP
U5.43 T6.8
*SIGNAL* P4MDIB+
T6.67 J4.35
*SIGNAL* P4MDIB-
T6.68 J4.38
*SIGNAL* P4MDIBN
U5.46 T6.5
*SIGNAL* P4MDIBP
U5.45 T6.6
*SIGNAL* P4MDIC+
T6.69 J4.36
*SIGNAL* P4MDIC-
T6.70 J4.37
*SIGNAL* P4MDICN
U5.49 T6.3
*SIGNAL* P4MDICP
U5.48 T6.4
*SIGNAL* P4MDID+
T6.71 J4.39
*SIGNAL* P4MDID-
T6.72 J4.40
*SIGNAL* P4MDIDN
U5.51 T6.1
*SIGNAL* P4MDIDP
U5.50 T6.2
*SIGNAL* PLLVDDL0
U5.15 C29.1 C28.1 L4.2
*SIGNAL* PLLVDDL1
U5.53 C22.1 C23.1 L3.1
*SIGNAL* SCK
U5.81 U3.6 J1.1 R9.2 R15.1
*SIGNAL* SDA
U5.82 U3.5 J1.3 R8.2
*SIGNAL* SPIF_CLK
U5.56 R22.1 RA1.4
*SIGNAL* SPIF_D0
U5.57 R21.1 RA1.3
*SIGNAL* SPIF_D1
U5.58 R20.1 RA1.2
*SIGNAL* SPIF_NCS
U5.59 R19.1 RA1.1
*SIGNAL* UART_RX
U5.54 R24.1 J2.1
*SIGNAL* UART_TX
U5.55 R23.1 J2.2
*END*
