kritikagithubtripathi/SOHO_Gigabit_Network_Switch/NETLIST/RTL8370N-VB-8GE_NETLIST.XLS

*PADS-PCB*
*PART*
C100 C0402
C101 C0402
C102 C0402
C103 C0402
C104 C0402
C105 C0402
C106 C0402
C107 C0402
C108 C0402
C109 C0402
C110 C0402
C111 C0402
C112 C0402
C113 C0402
C114 C0402
C117 C0402
C196 C0402
C197 C0402
C198 C0402
C199 C0402
C200 C0402
C201 C0402
C202 C0402
C203 C0402
C204 C0402
C205 C0402
C206 C0402
C207 C0402
C208 C0402
C209 C0402
C210 C0402
C211 C0402
C212 C0402
C213 C0402
C214 C0402
C215 C0402
C216 C0402
C217 C0402
C218 C0402
C219 C0402
C220 C0402
C221 C0402
C222 C0402
C223 C0402
C224 C0402
C225 C0402
C226 C0402
C227 C0402
C228 C0402
C229 C0402
C230 C0402
C231 C0402
C232 C0402
C233 C0402
C234 C0402
C235 C0402
C236 C0402
C237 C0402
C238 C0402
C239 C0402
C240 C0402
C241 C0402
C242 C0402
C243 C0402
C244 C0402
C245 C0402
C246 C0402
C247 C0402
C248 C0402
C249 C0402
C250 C0402
C251 C0402
C252 C0402
C253 C0402
C254 C0402
C255 C0402
C256 C0402
C257 C0402
C258 C0402
C259 C0402
C288 C0402
C289 C0603
C290 C0402
C291 C0402
C292 C0603
C293 C0402
C294 C0402
C295 C0402
C296 C0402
C297 C0402
C298 C0402
C299 C0402
C300 C0402
C301 C0402
C302 C0402
C303 C0402
C304 C0402
C305 C0402
C306 C0402
C307 C0402
C308 C0402
C309 C0402
C310 C0402
C311 C0402
C312 C0402
C313 C0402
C314 C0402
C315 C0402
C316 C0402
C317 C0402
C318 C0402
C319 C0603
C320 C0402
C321 C0402
C322 C0805
C323 C0402
C327 C0805
C330 C0805
C331 C0402
C333 C0805
C334 C0603
C335 C0402
C336 C0603
C337 C0402
C338 C0603
C339 C0402
C340 C0402
C341 C0603
C342 CAP_AE_CAN_D
C343 C0603
C344 C0603
C345 CAP_AE_CAN_D
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
T11.17 J6.46
*SIGNAL* P5MDIBN
U2.38 T11.8 C237.1
*SIGNAL* P5MDIBP
U2.37 T11.9 C240.1
*SIGNAL* P5MDIC+
T11.19 J6.44
*SIGNAL* P5MDIC-
T11.20 J6.45
*SIGNAL* P5MDICN
U2.41 T11.5 C236.1
*SIGNAL* P5MDICP
U2.40 T11.6 C238.1
*SIGNAL* P5MDID+
T11.22 J6.47
*SIGNAL* P5MDID-
T11.23 J6.48
*SIGNAL* P5MDIDN
U2.43 T11.2 C241.1
*SIGNAL* P5MDIDP
U2.42 T11.3 C243.1
*SIGNAL* P6LED0
U2.71 SR14.2 RP12.2
*SIGNAL* P6LED1
U2.72 RP11.2 SR15.2
*SIGNAL* P6MDIA+
T10.13 J6.49
*SIGNAL* P6MDIA-
T10.14 J6.50
*SIGNAL* P6MDIAN
U2.46 T10.11 C247.1
*SIGNAL* P6MDIAP
U2.45 T10.12 C250.1
*SIGNAL* P6MDIB+
T10.16 J6.51
*SIGNAL* P6MDIB-
T10.17 J6.54
*SIGNAL* P6MDIBN
U2.48 T10.8 C245.1
*SIGNAL* P6MDIBP
U2.47 T10.9 C248.1
*SIGNAL* P6MDIC+
T10.19 J6.52
*SIGNAL* P6MDIC-
T10.20 J6.53
*SIGNAL* P6MDICN
U2.51 T10.5 C244.1
*SIGNAL* P6MDICP
U2.50 T10.6 C246.1
*SIGNAL* P6MDID+
T10.22 J6.55
*SIGNAL* P6MDID-
T10.23 J6.56
*SIGNAL* P6MDIDN
U2.53 T10.2 C249.1
*SIGNAL* P6MDIDP
U2.52 T10.3 C251.1
*SIGNAL* P7LED0
U2.68 SR12.2 RP10.2
*SIGNAL* P7LED1
U2.69 RP9.2 SR13.2
*SIGNAL* P7MDIA+
T9.13 J6.57
*SIGNAL* P7MDIA-
T9.14 J6.58
*SIGNAL* P7MDIAN
U2.56 T9.11 C255.1
*SIGNAL* P7MDIAP
U2.55 T9.12 C258.1
*SIGNAL* P7MDIB+
T9.16 J6.59
*SIGNAL* P7MDIB-
T9.17 J6.62
*SIGNAL* P7MDIBN
U2.58 T9.8 C253.1
*SIGNAL* P7MDIBP
U2.57 T9.9 C256.1
*SIGNAL* P7MDIC+
T9.19 J6.60
*SIGNAL* P7MDIC-
T9.20 J6.61
*SIGNAL* P7MDICN
U2.61 T9.5 C252.1
*SIGNAL* P7MDICP
U2.60 T9.6 C254.1
*SIGNAL* P7MDID+
T9.22 J6.63
*SIGNAL* P7MDID-
T9.23 J6.64
*SIGNAL* P7MDIDN
U2.63 T9.2 C257.1
*SIGNAL* P7MDIDP
U2.62 T9.3 C259.1
*SIGNAL* PLLVDDL0
U2.122 C321.1 C319.1 L18.2
*SIGNAL* PLLVDDL1
U2.44 L17.1 C294.1 C292.1
*SIGNAL* SCK
U2.100 U7.6 R9.1 R15.2 J1.4
*SIGNAL* SDA
U2.101 U7.5 R119.1 J1.2
*SIGNAL* STRP_DIS_8051
U2.85 R44.2 R45.1
*SIGNAL* STRP_EN_EEE
U2.90 RP21.2 SR25.2 R40.1 R39.2
*SIGNAL* STRP_EN_PHY
U2.91 R35.2 R153.1 R152.2 R37.1
*SIGNAL* STRP_EN_PWRLIGHT
U2.83 R55.1 R46.2
*SIGNAL* STRP_SMI_SEL_1
U2.88 R42.2 R43.1
*END*
