kritikagithubtripathi/SOHO_Gigabit_Network_Switch/Schematic/RTL8367N-VB-5GE-SCH.pdf

# RTL8367N-VB (QFN88) Block Diagram

# EEPROM

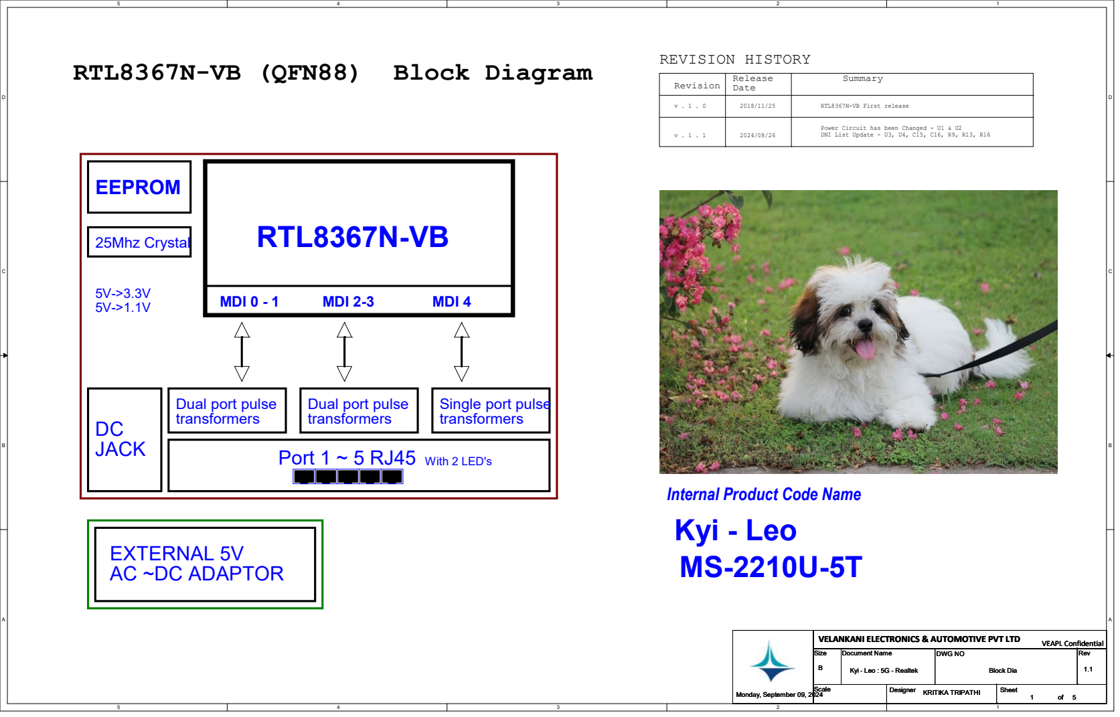
[picture p28: page 1]
MDI 0 - 1; MDI 4; 25Mhz Crystal; DC JACK; RTL8367N-VB; MDI 2-3; With 2 LED's; REVISION HISTORY; Release Date; Summary; Revision; RTL8367N-VB First release; DNI List Update - U3, U4, C15, C16, R9, R13, R16; Size Scale; Document Name; DWG NO; Rev Sheet; of Designer; VELANKANI ELECTRONICS & AUTOMOTIVE PVT LTD; VEAPL Confidential 1.1 Monday, September 09, 2024; Kyi - Leo : 5G - Realtek KRITIKA TRIPATHI Block Dia Size Scale; Kyi - Leo : 5G - Realtek KRITIKA TRIPATHI Block Dia

Power Circuit has been Changed - U1 & U2

Dual port pulse
transformers

Port 1 ~ 5 RJ45

Single port pulse

Internal Product Code Name
Kyi - Leo

EXTERNAL 5V
AC ~DC ADAPTOR

## 3.3 VDC

## POWER CIRCUIT

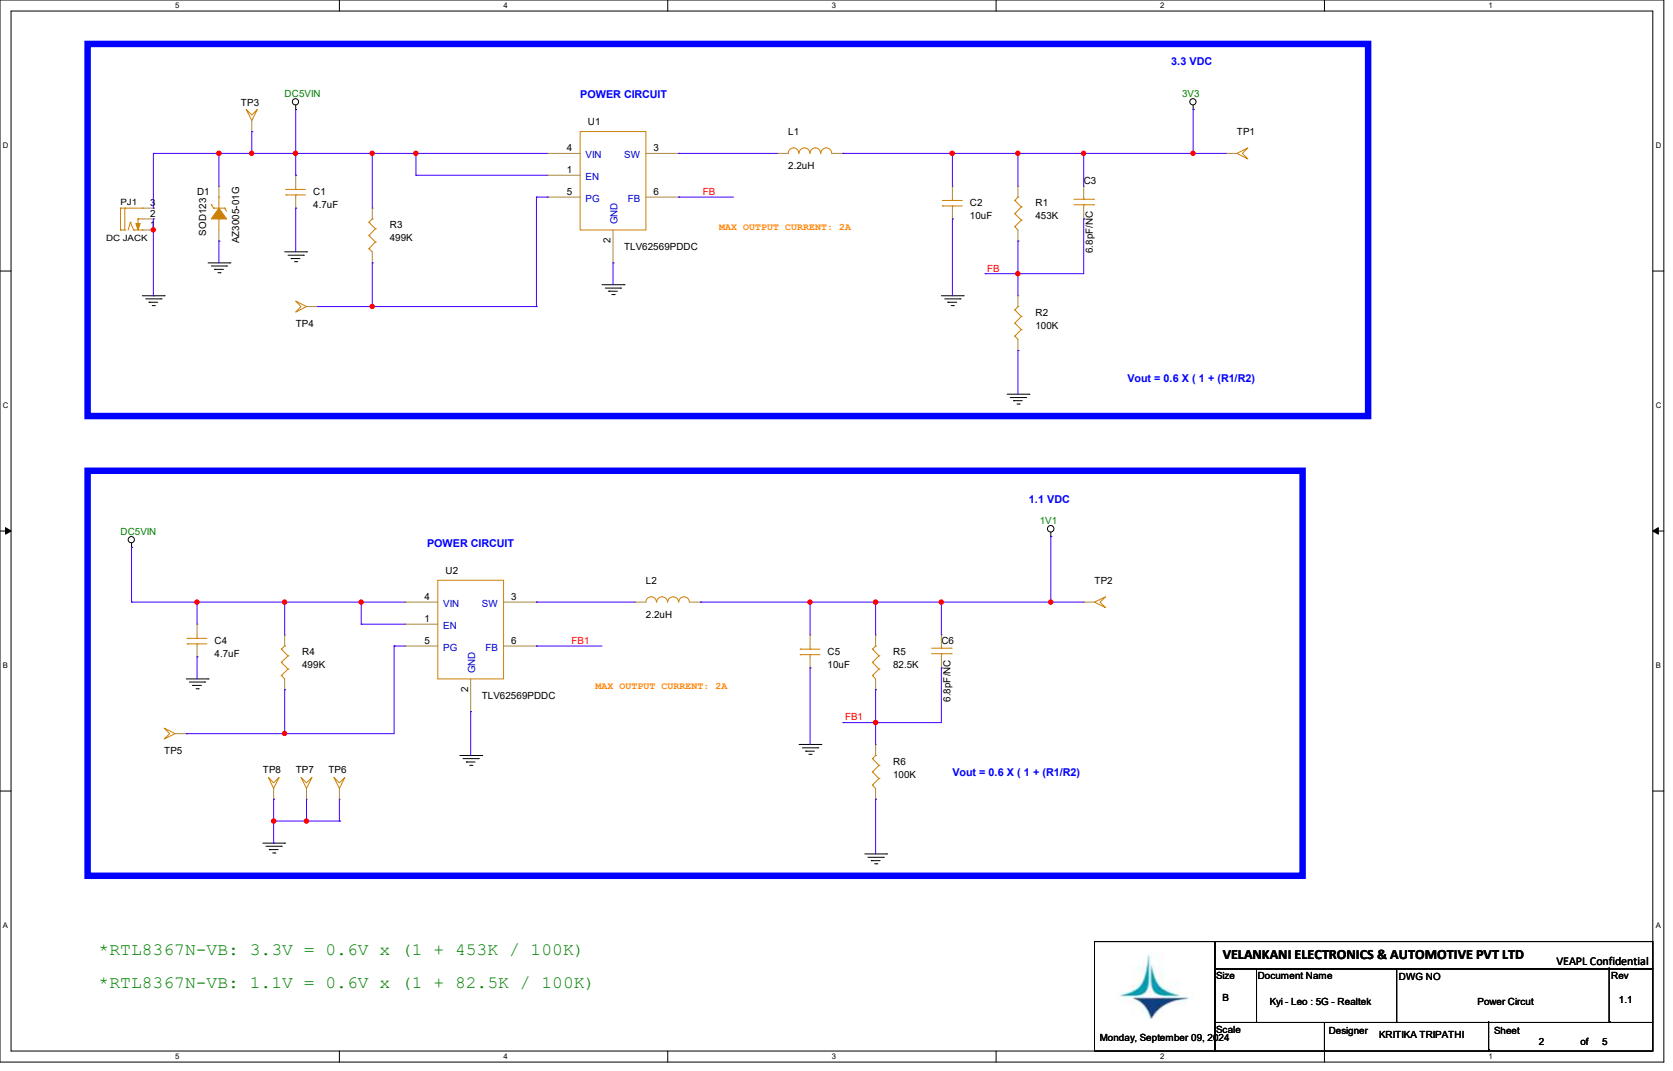
[picture p29: page 2]

# R8NC/4.7K C29

## R134.7K/NC

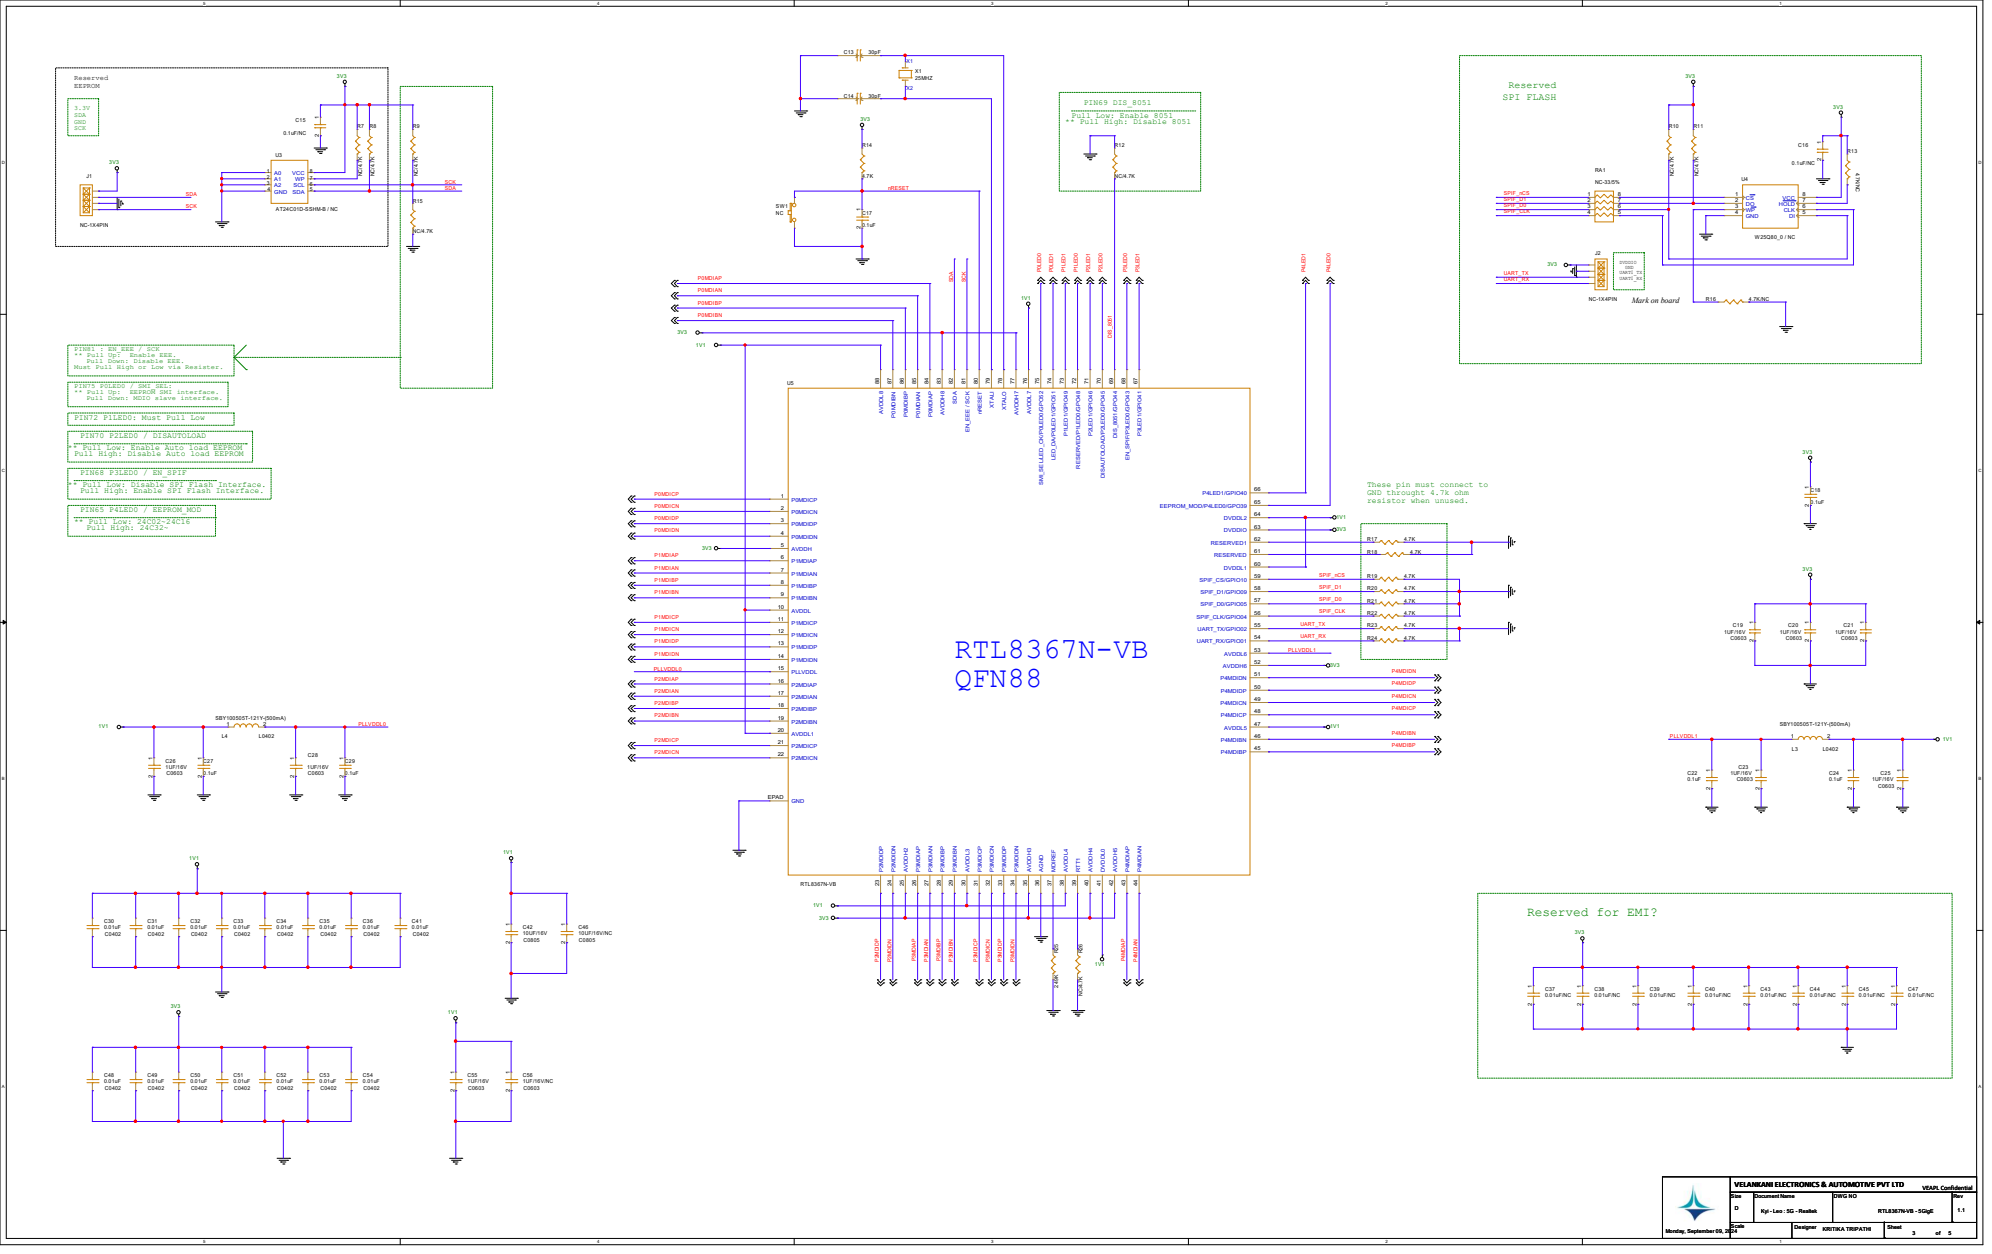
[picture p30: page 3]

PIN81 : EN_EEE / SCK
** Pull Up: Enable EEE.
Pull Down: Disable EEE.
Must Pull High or Low via Resister.

PIN75 P0LED0 / SMI_SEL:
** Pull Up: EEPROM SMI interface.
Pull Down: MDIO slave interface.

PIN70 P2LED0 / DISAUTOLOAD
** Pull Low: Enable Auto load EEPROM
Pull High: Disable Auto load EEPROM

PIN68 P3LED0 / EN_SPIF
** Pull Low: Disable SPI Flash Interface.
Pull High: Enable SPI Flash Interface.

These pin must connect to

P4-8 40 P4-7 39 P4-6 38 P4-5 37 P4-4 36 P4-3 35 P4-2 34 P4-1 33 P3-8 32 P3-7 31 P3-6 30 P3-5 29 P3-4 28 P3-3 27 P3-2 26 P3-1 25 P2-8 24 P2-7 23 P2-6 22 P2-5 21 P2-4 20 P2-3 19 P2-2 18 P2-1 17 P1-8 16 P1-7 15 P1-6 14 P1-5 13 P1-4 12 P1-3 11 P1-2 10 P1-1 9 P0-8 8 P0-7 7 P0-6 6 P0-5 5 P0-4 4 P0-3 3 P0-2 2 P0-1 1

# MCT1 64 MCT2 55 MCT3 46 MCT4 37

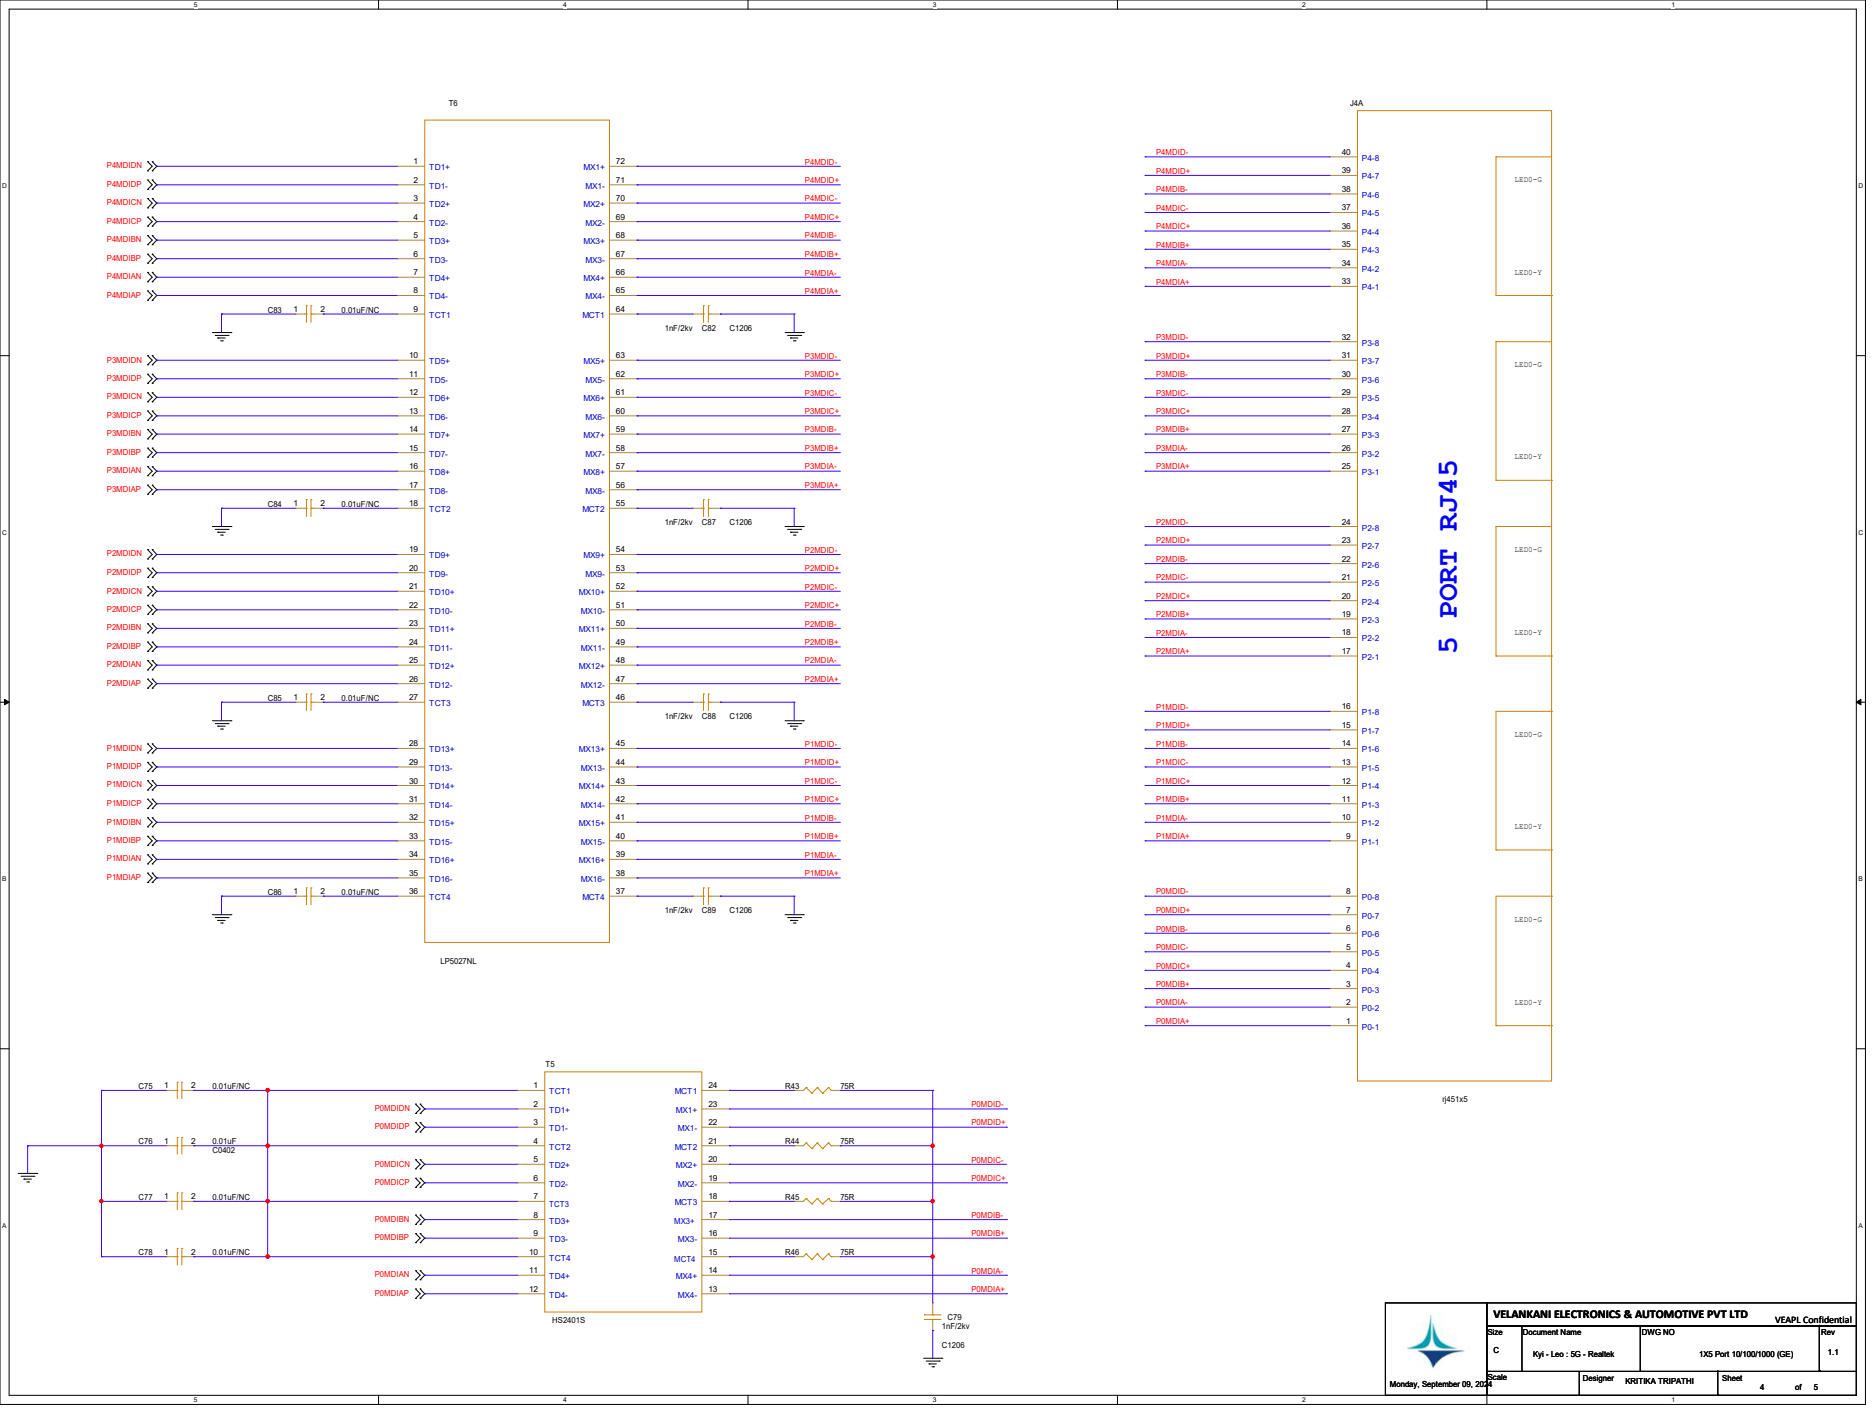
[picture p31: page 4]

# Port 0 LED

# Port 3 LED

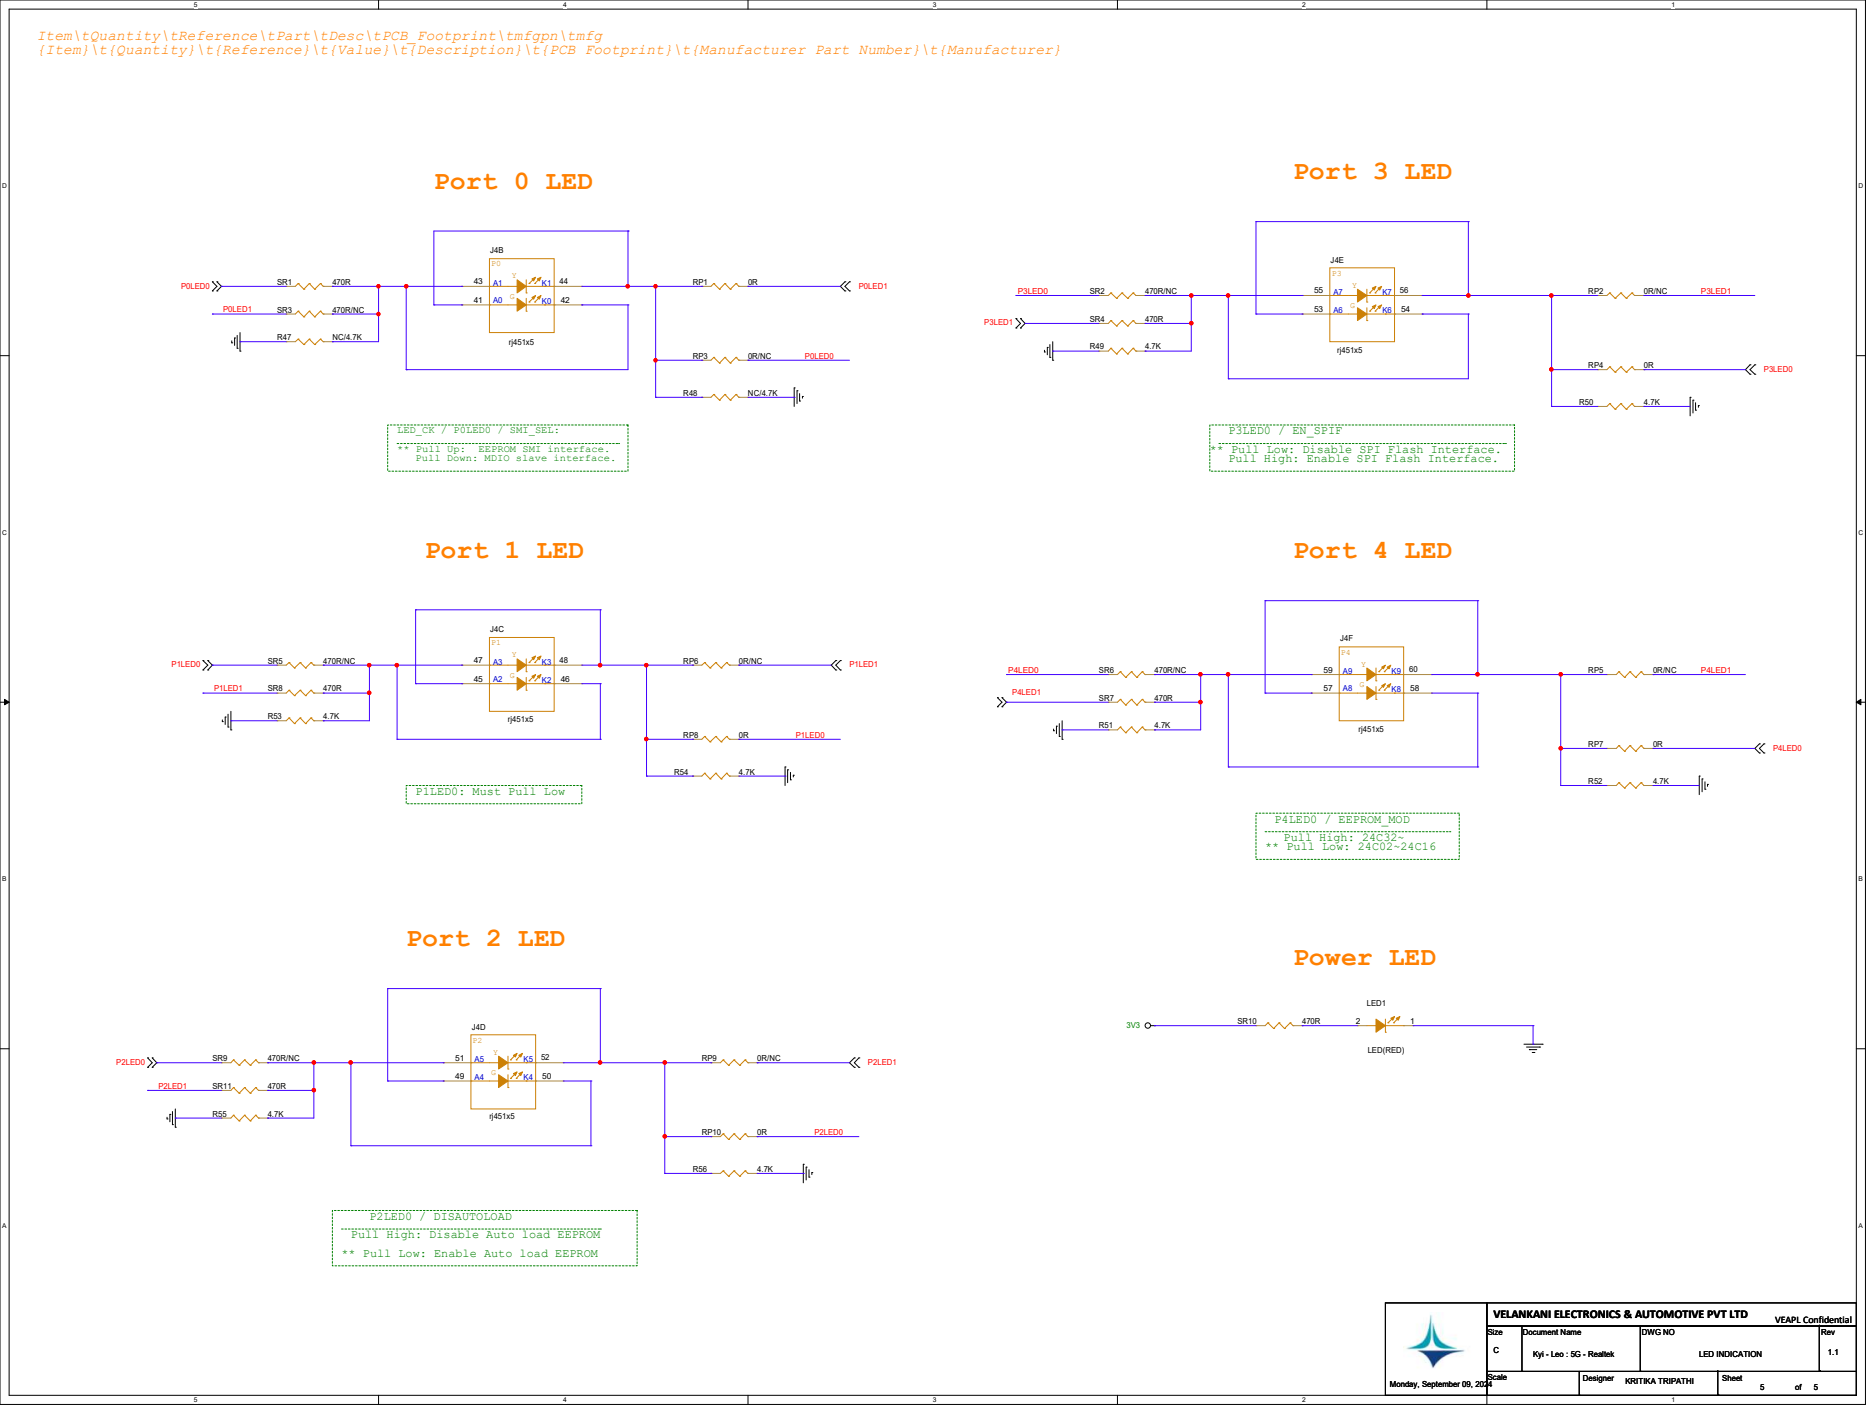
[picture p32: page 5]

Item\tQuantity\tReference\tPart\tDesc\tPCB_Footprint\tmfgpn\tmfg
{Item}\t{Quantity}\t{Reference}\t{Value}\t{Description}\t{PCB Footprint}\t{Manufacturer Part Number}\t{Manufacturer}

LED_CK / P0LED0 / SMI_SEL:
** Pull Up: EEPROM SMI interface.
Pull Down: MDIO slave interface.

P3LED0 / EN_SPIF
** Pull Low: Disable SPI Flash Interface.
Pull High: Enable SPI Flash Interface.

P2LED0 / DISAUTOLOAD
Pull High: Disable Auto load EEPROM
** Pull Low: Enable Auto load EEPROM
