kritikagithubtripathi/SOHO_Gigabit_Network_Switch/Schematic/RTL8370N-VB-8GE.pdf

5

4

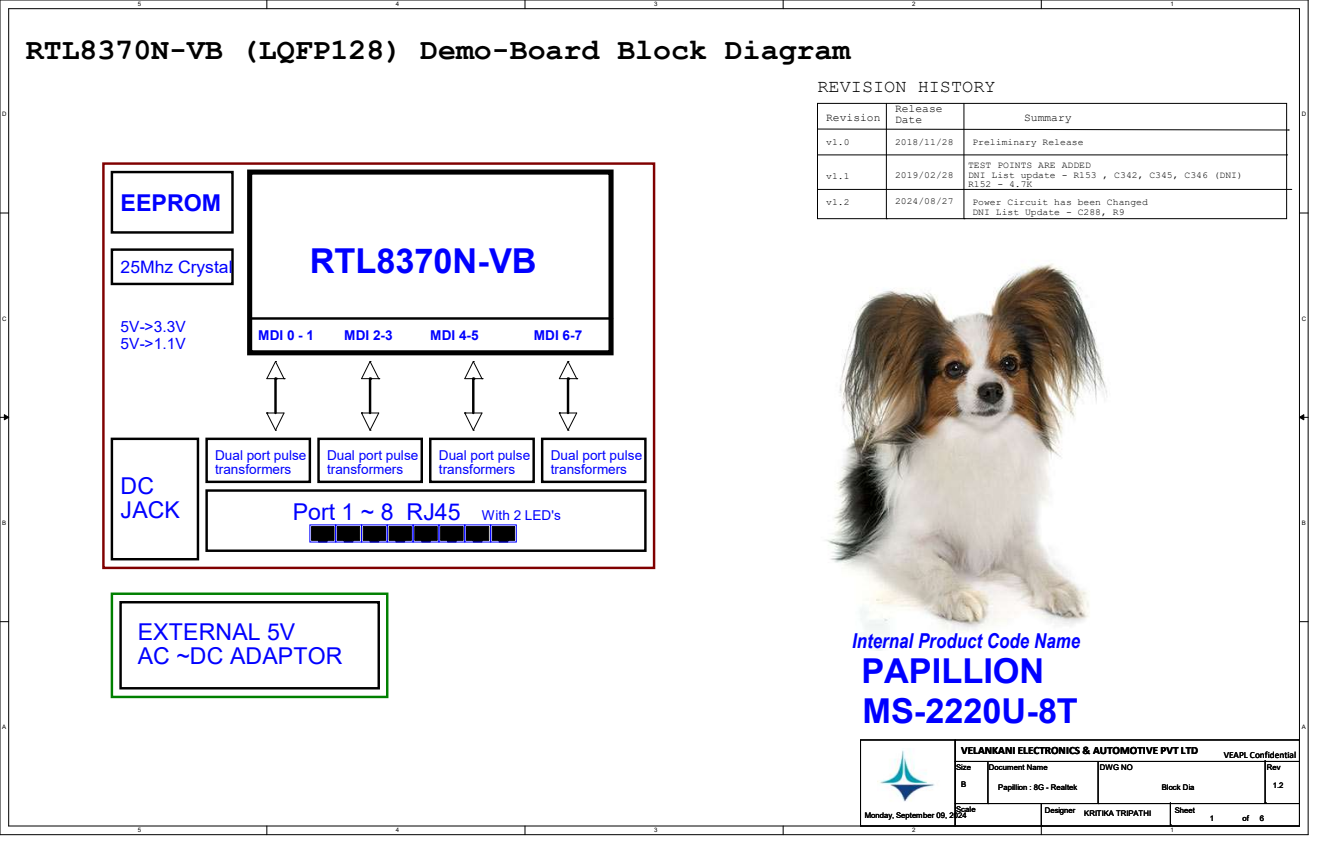
[picture p33: page 1]
Release Date; Preliminary Release; REVISION HISTORY; Summary; Revision; DC JACK; MDI 6-7; MDI 2-3; With 2 LED's; 25Mhz Crystal; RTL8370N-VB; MDI 4-5; MDI 0 - 1; EEPROM; Power Circuit has been Changed; Size Scale; Document Name; DWG NO; Rev Sheet; of Designer; VELANKANI ELECTRONICS & AUTOMOTIVE PVT LTD; VEAPL Confidential 1.2 Monday, September 09, 2024; Papillion : 8G - Realtek KRITIKA TRIPATHI Block Dia Size Scale; Papillion : 8G - Realtek KRITIKA TRIPATHI Block Dia

RTL8370N-VB (LQFP128) Demo-Board Block Diagram

TEST POINTS ARE ADDED
DNI List update - R153 , C342, C345, C346 (DNI)

DNI List Update - C288, R9

Dual port pulse
transformers
Port 1 ~ 8 RJ45

EXTERNAL 5V
AC ~DC ADAPTOR

Internal Product Code Name
PAPILLION

# Power LED

# POWER CIRCUIT

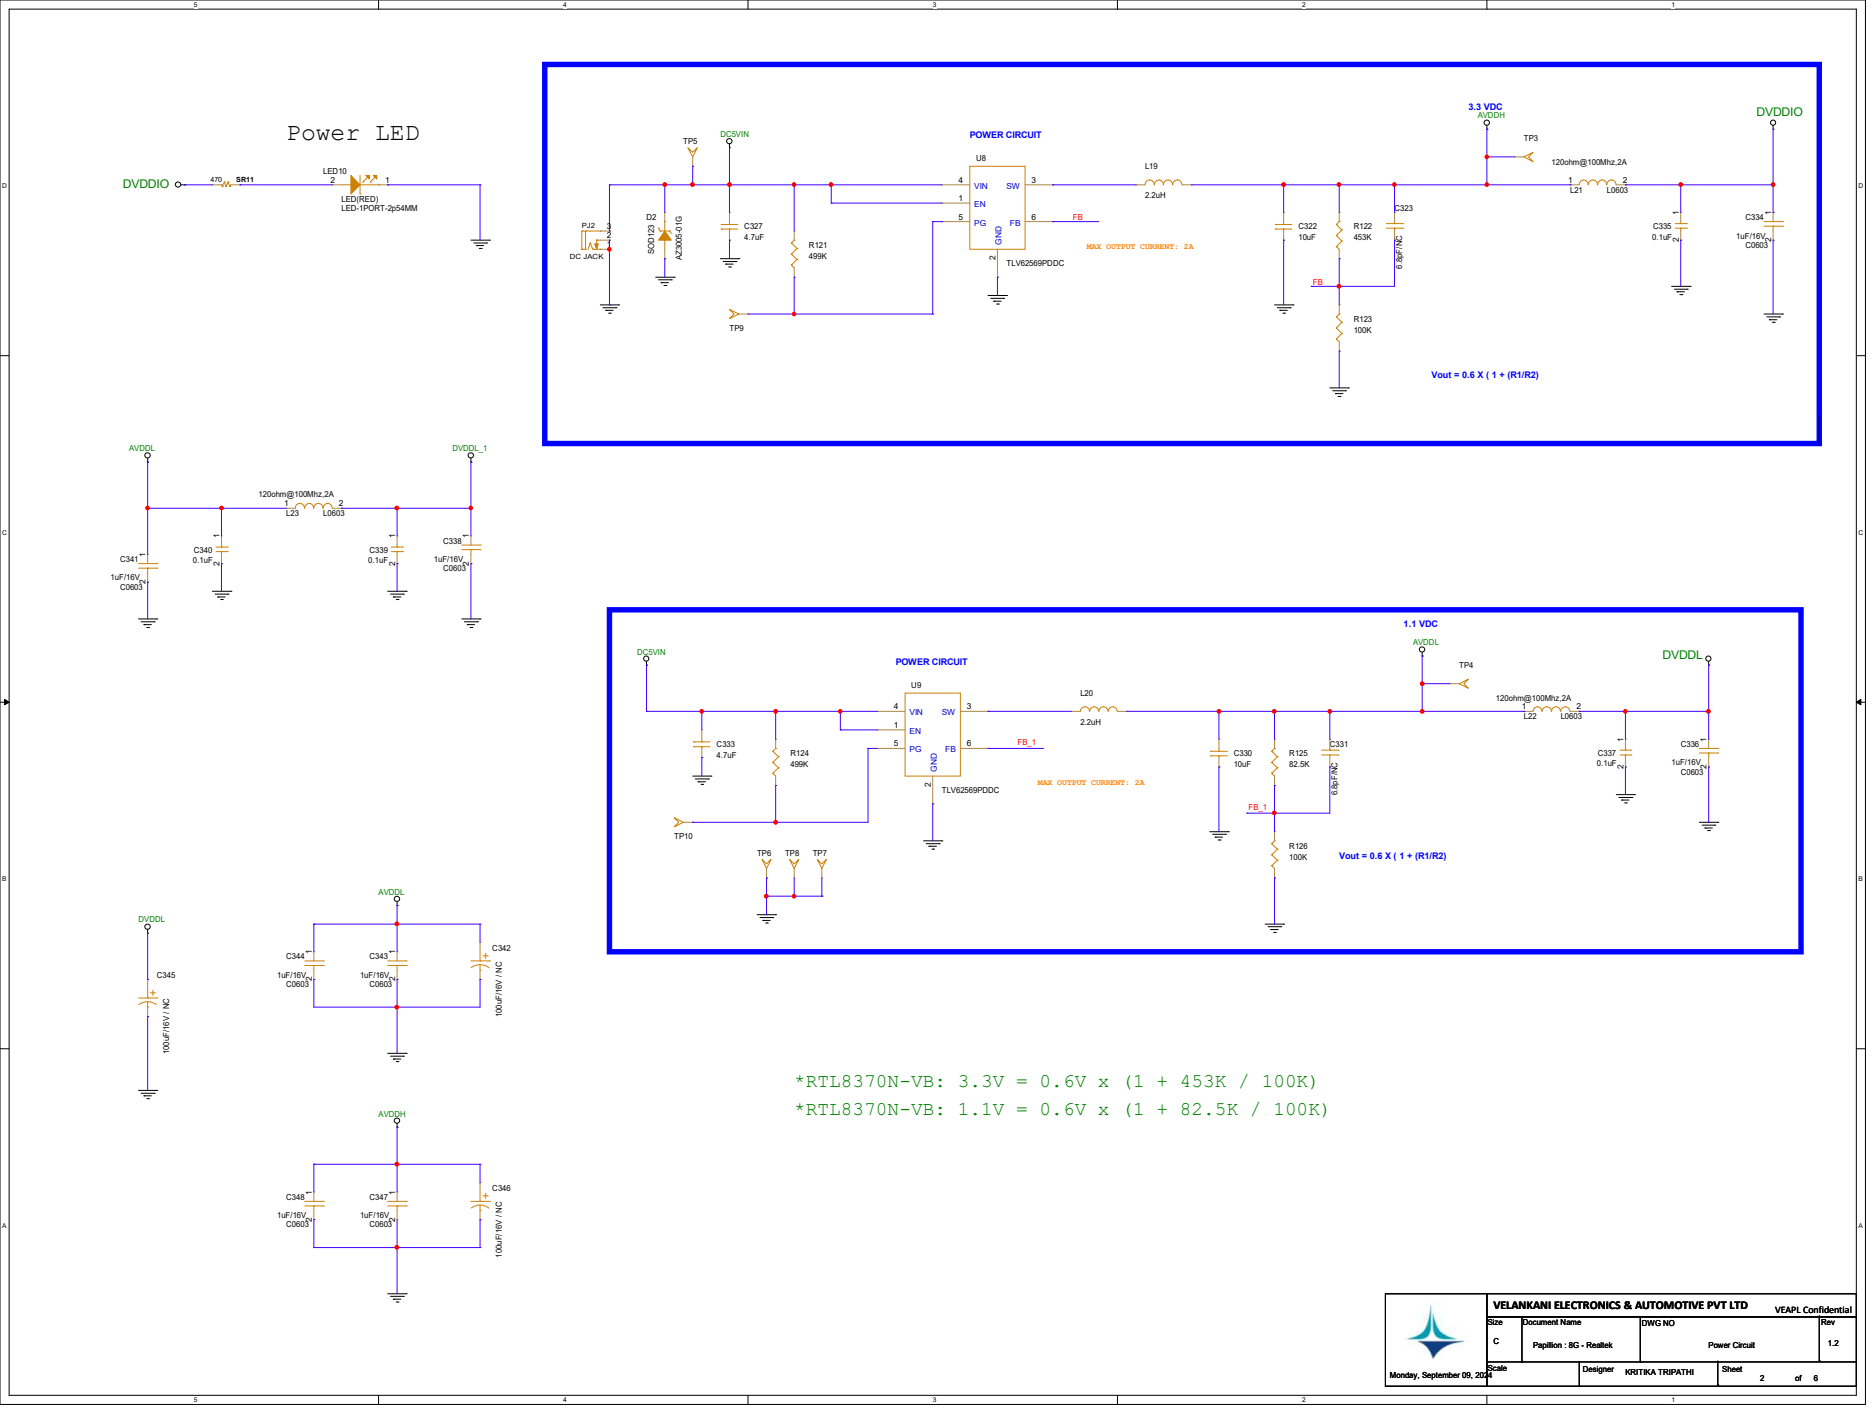
[picture p34: page 2]

## Pull High: Disable Auto load EEPROM

## Pull High: 24C32~

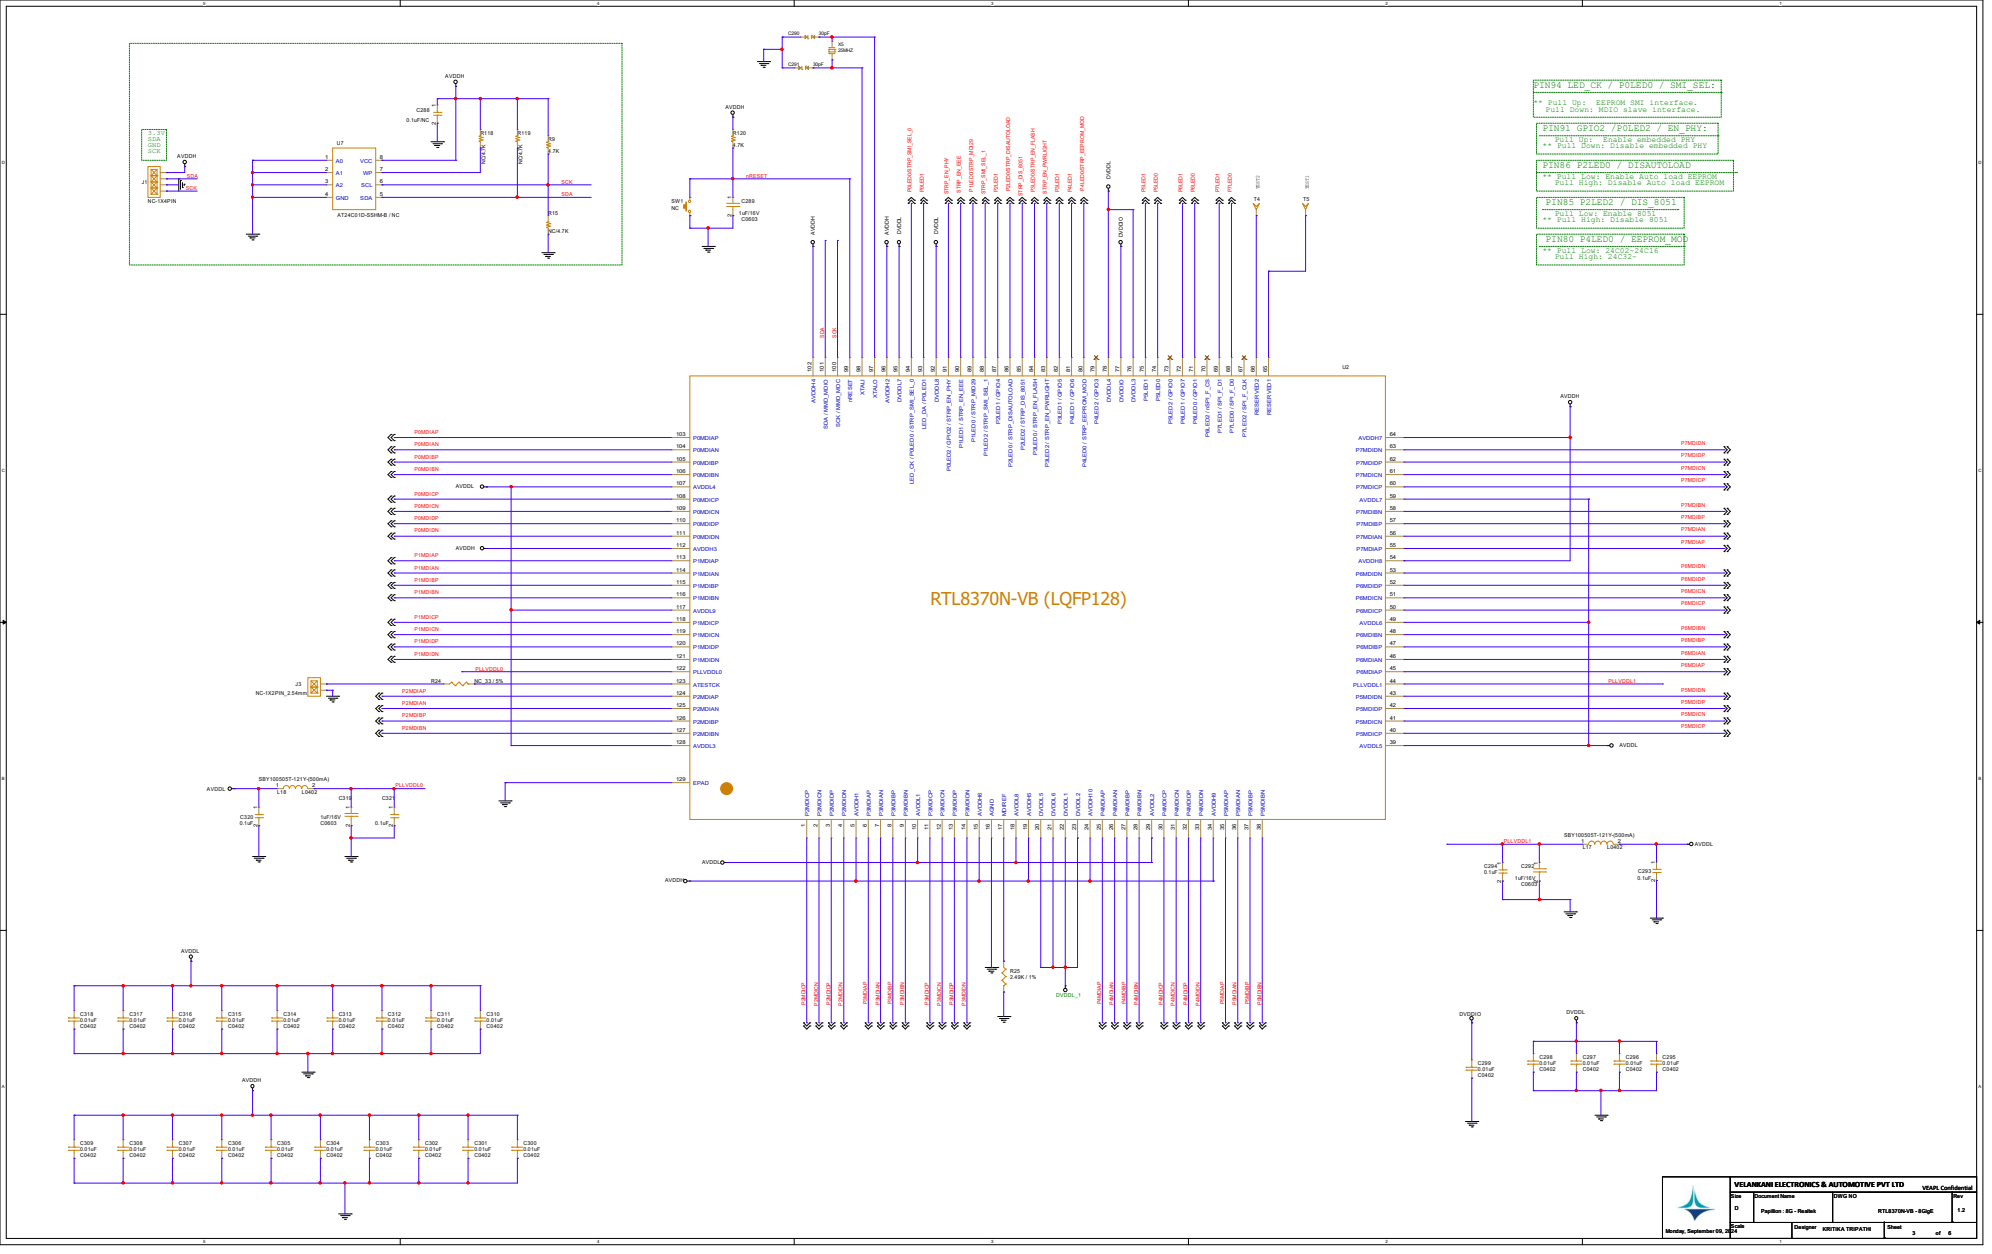
[picture p35: page 3]

** Pull Up: EEPROM SMI interface. ** Pull Low: Enable Auto load EEPROM
Pull Down: MDIO slave interface.
PIN91 GPIO2 /P0LED2 / EN_PHY:
Pull Up: Enable embedded PHY Pull Low: Enable 8051
** Pull Down: Disable embedded PHY
PIN86 P2LED0 / DISAUTOLOAD ** Pull Low: 24C02~24C16

T7 H82409S | MCT1 | 24 MCT2 | 21 MCT3 | 18 MCT4 | 15 MX1+
T9 H82409S | MCT1 | 24 MCT2 | 21 MCT3 | 18 MCT4 | 15 MX1+

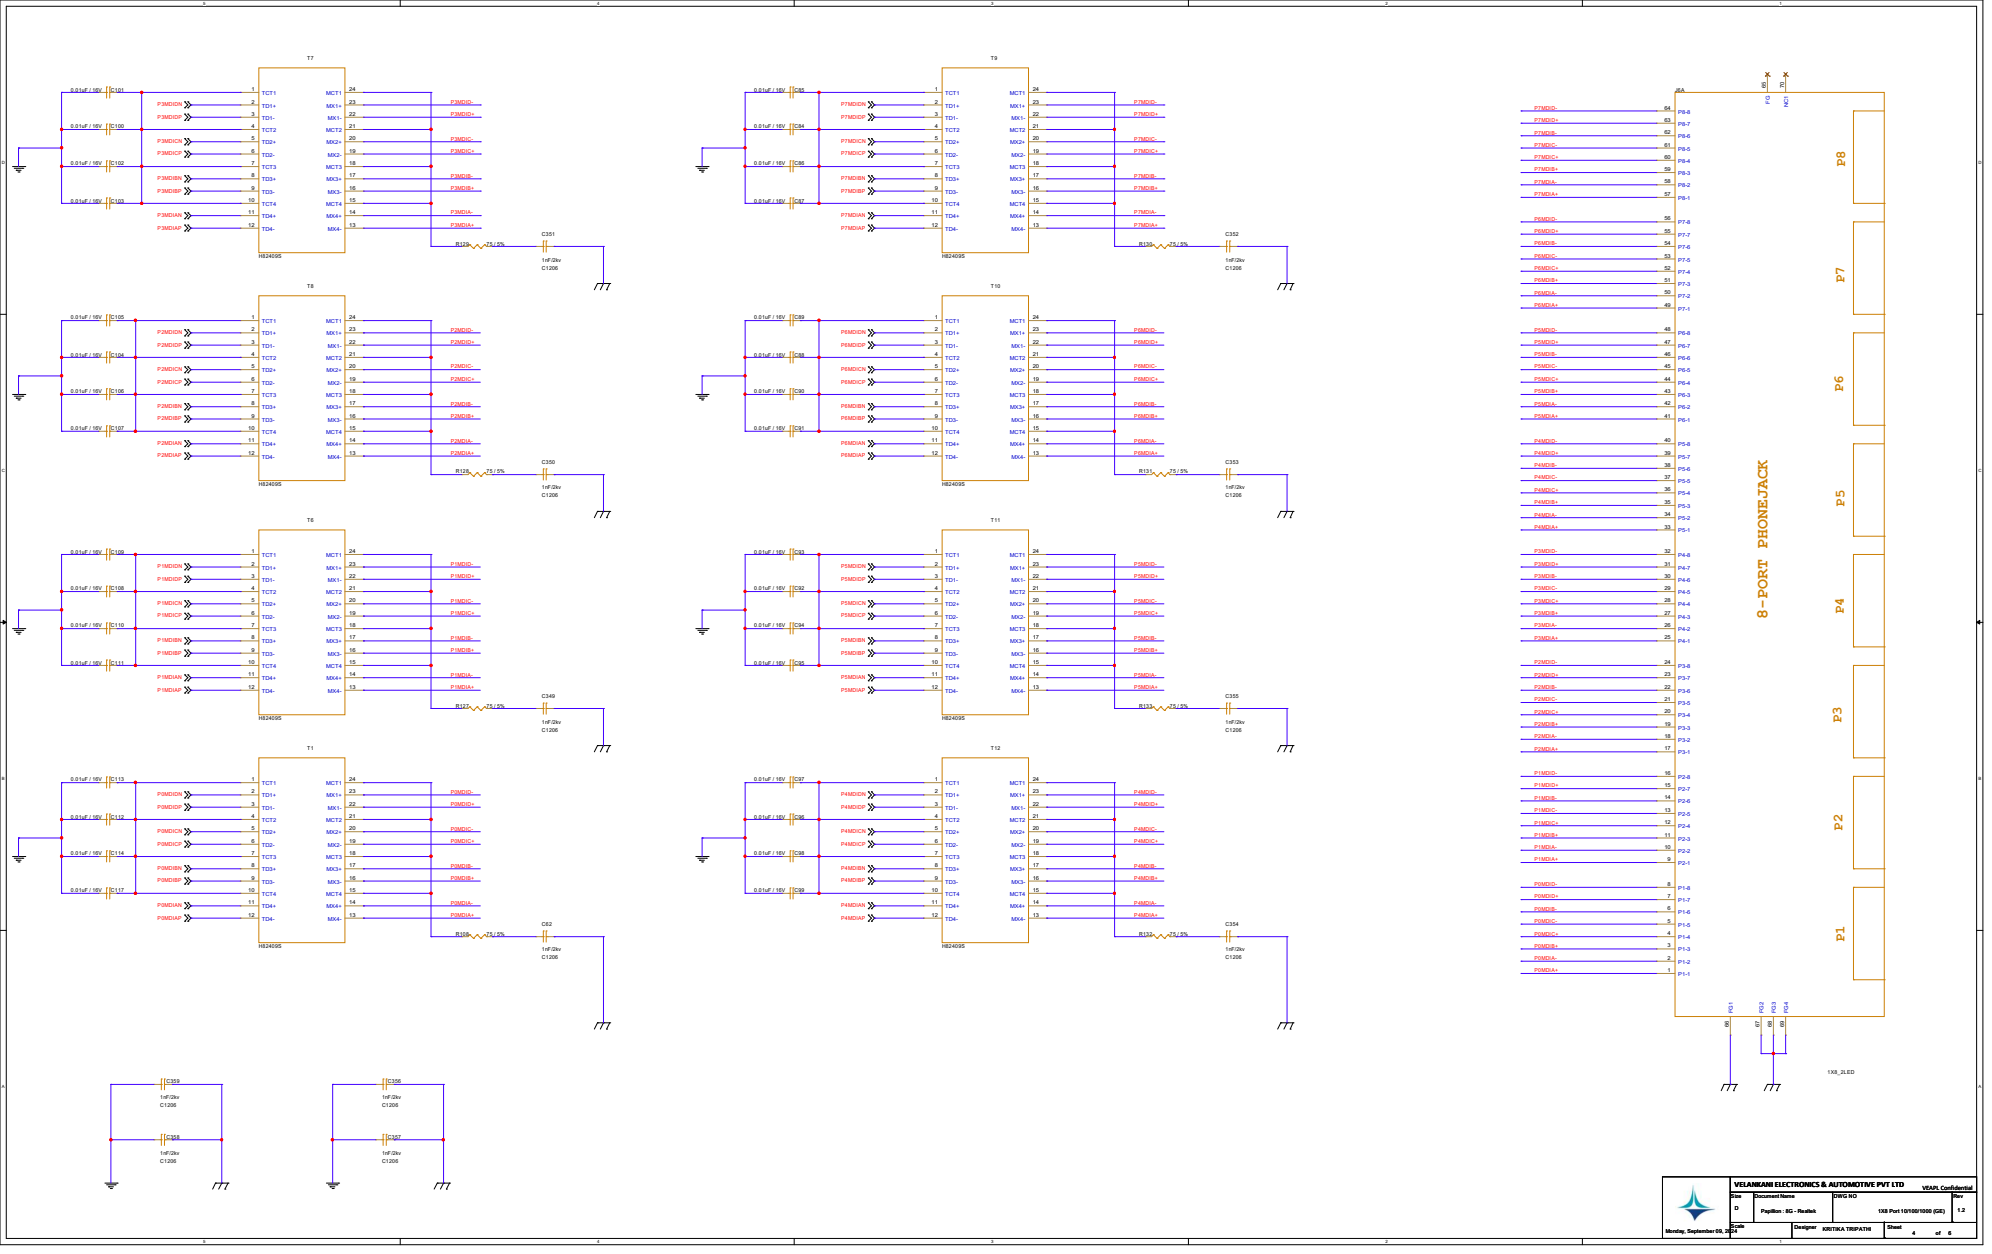
[picture p36: page 4]

# Port 0 LED

# Port 1 LED

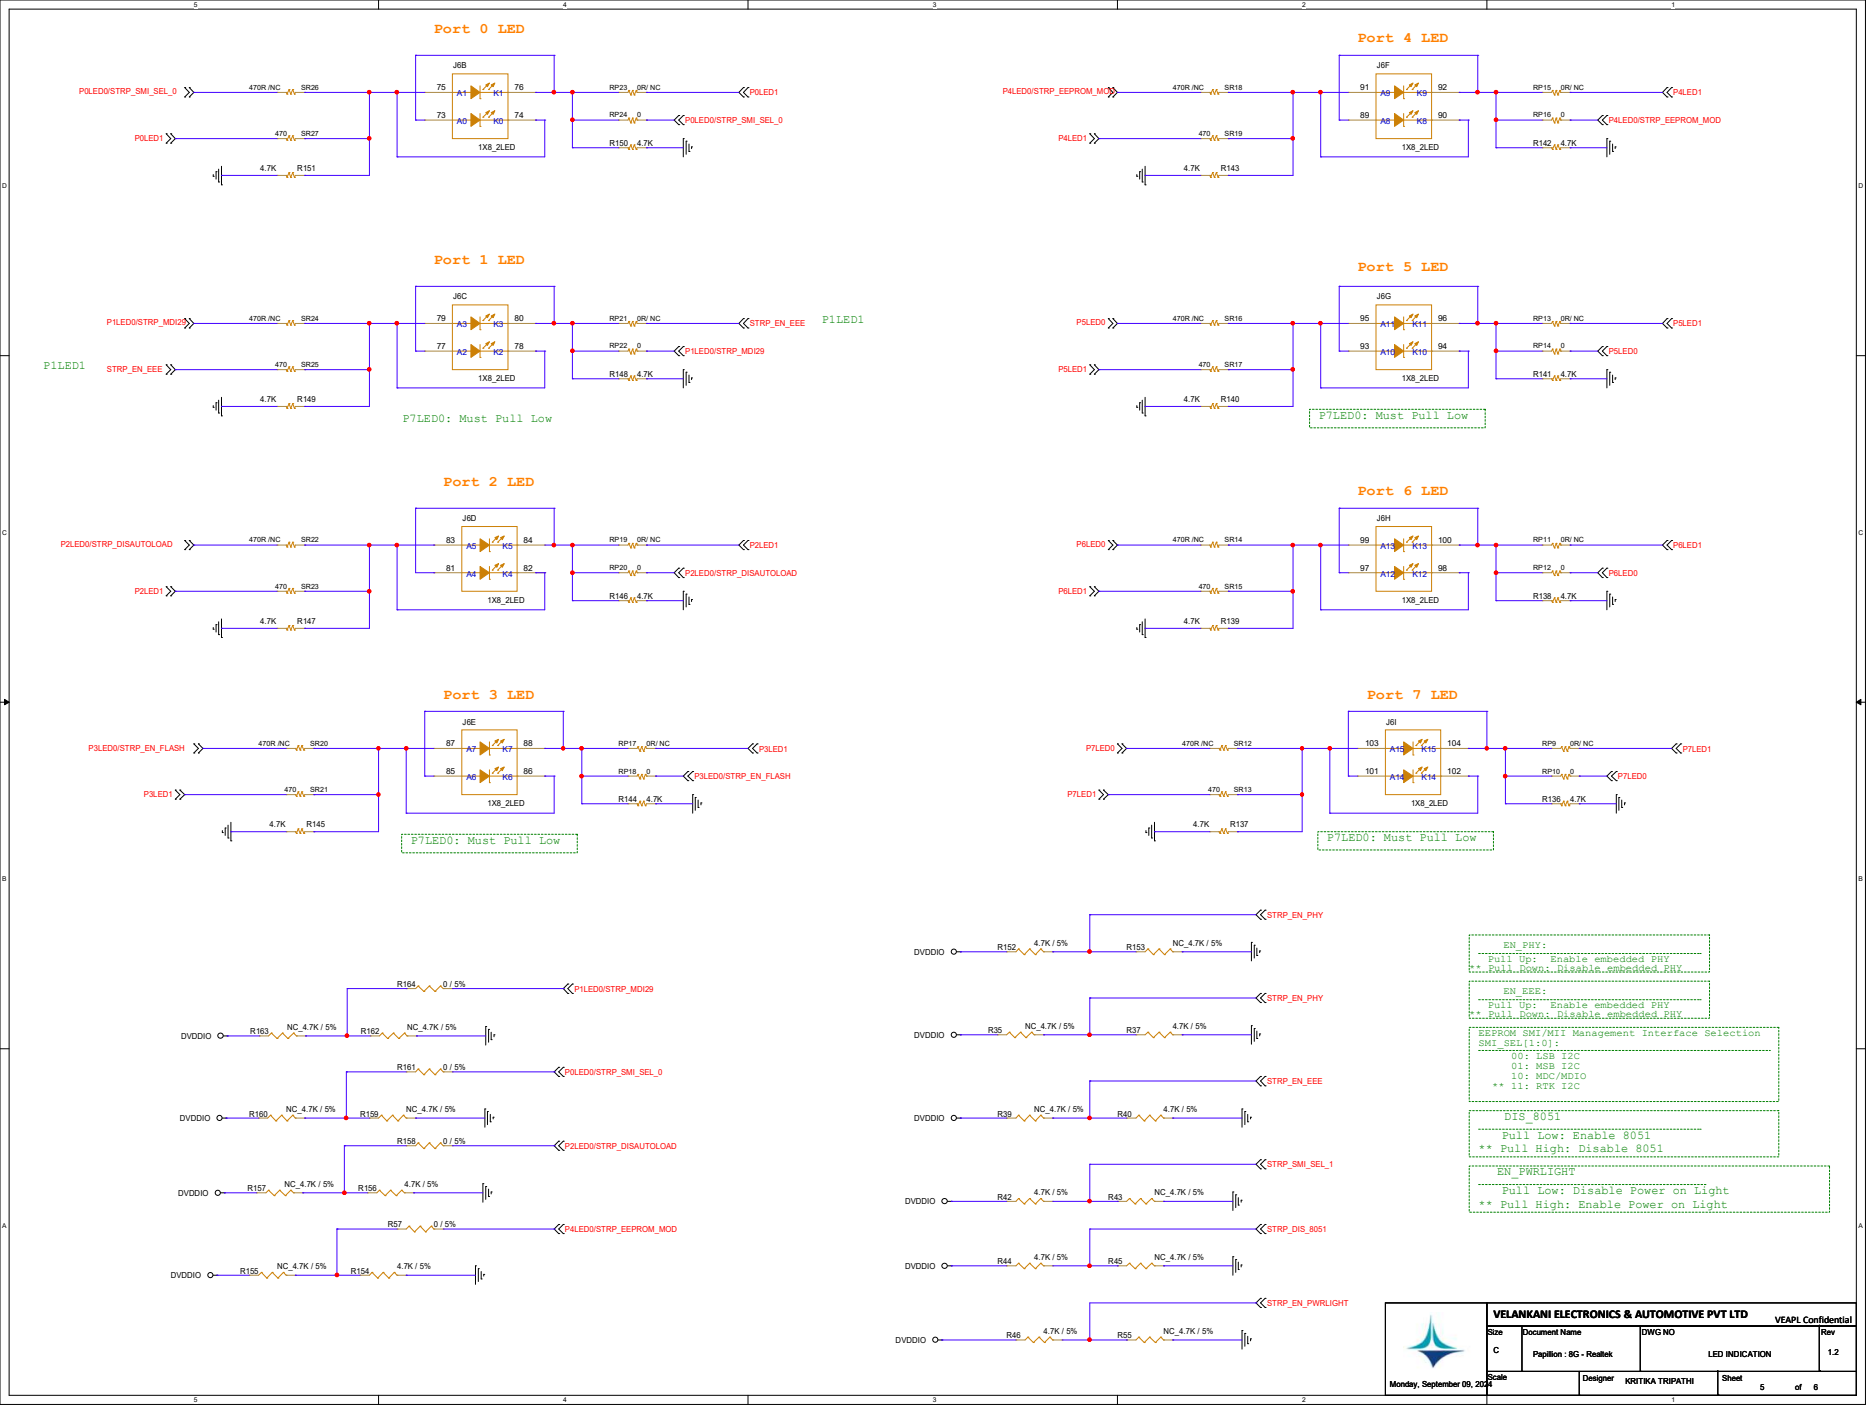
[picture p37: page 5]

P7LED0: Must Pull Low DVDDIO

EN_PHY:
Pull Up: Enable embedded PHY
** Pull Down: Disable embedded PHY

EN_EEE:
EEPROM SMI/MII Management Interface Selection
SMI_SEL[1:0]:
00: LSB I2C
01: MSB I2C
10: MDC/MDIO
** 11: RTK I2C

Pull Low: Enable 8051
** Pull High: Disable 8051
EN_PWRLIGHT
Pull Low: Disable Power on Light
** Pull High: Enable Power on Light

D D

Reserved For EMI/ESD TEST GND | GND | GND | GND

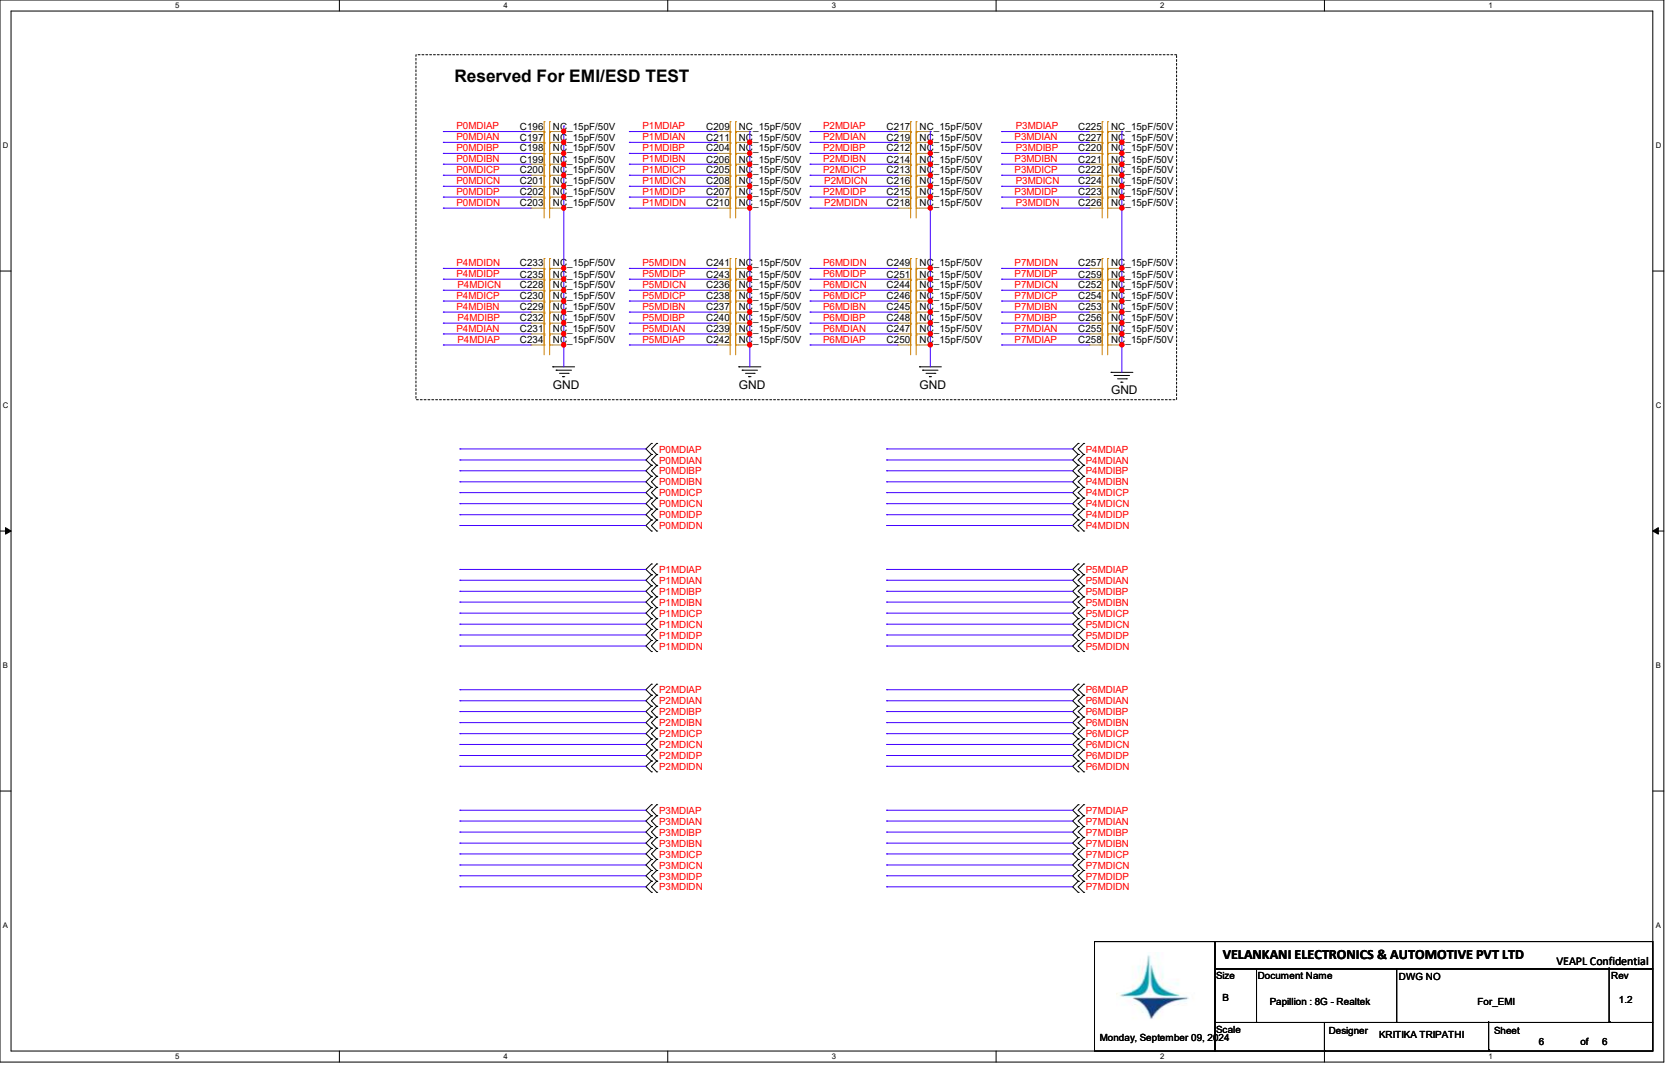
[picture p38: page 6]
