kritikagithubtripathi/SOHO_Gigabit_Network_Switch/(list of files, drawings)

Other design files:
Schematic/RTL8367N-VB-5GE-SCH.DSN
Schematic/RTL8370N-VB-8GE.DSN
